aweeri/Control-Avionics-RP2350/Firmware/RapidFishFW/LITE/GPIO-table.md

GPIO 0: 
GPIO 1:
GPIO 2: I2C1 SDA
GPIO 3: I2C1 SCL
GPIO 4: I2C0 SDA
GPIO 5: I2C0 SCL
GPIO 6: RADIO DIO5
GPIO 7: RADIO DIO6
GPIO 8: GNSS UART1 TX
GPIO 9: GNSS UART1 RX
GPIO 10: RADIO BUSY
GPIO 11: RADIO RESET
GPIO 12: RADIO SPI1 RX [MISO]
GPIO 13: RADIO SPI1 CSn [CS]
GPIO 14: RADIO SPI1 SCK [SCL]
GPIO 15: RADIO SPI1 TX [MOSI]
GPIO 16: IMU SPI0 RX [MISO]
GPIO 17: IMU SPI0 CSn [CS]
GPIO 18: IMU SPI0 SCK [SCL]
GPIO 19: IMU SPI0 TX [MOSI]
GPIO 20: SERVO PWM2
GPIO 21: PYRO_1 TRIGGER
GPIO 22: PYRO_2 TRIGGER
GPIO 23: SERVO PWM1
GPIO 24: BUZZER TRIGGER
GPIO 25: WS2812B SIGNAL
GPIO 26: BATTERY VOLTAGE ADC
GPIO 27: UNUSED ADC
GPIO 28: PYRO_1 CONTINUITY ADC
GPIO 29: PYRO_2 CONTINUITY ADC
