aweeri/Control-Avionics-RP2350/Hardware/CARP-DEV/addons/BMP390/10LGA_2X2X0p75_BOS.stl

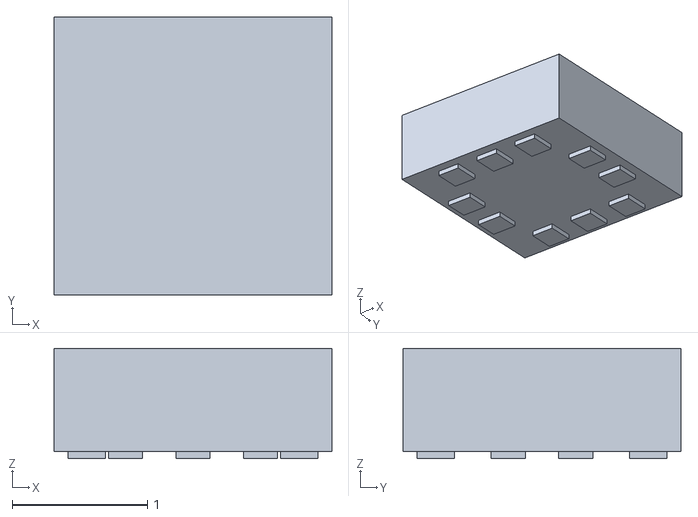
[picture p1: CAD file, 2026-06-29]
Hardware/CARP-DEV/addons/BMP390/10LGA_2X2X0p75_BOS.stl
2.06 x 2.06 x 0.815
