aweeri/Control-Avionics-RP2350/Hardware/CARP-DEV/RP2350_QFN60.step

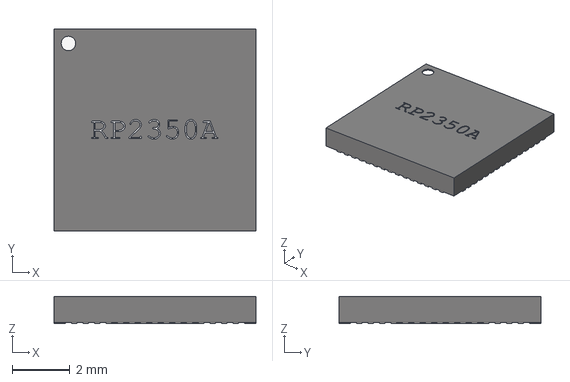
[picture p2: CAD file, 2026-06-29]
Hardware/CARP-DEV/RP2350_QFN60.step
7.00 x 7.00 x 0.95 mm
