aweeri/Control-Avionics-RP2350/Hardware/CARP-LITE/rev1.0/TEST_RESULTS.md

* OSP finish SUCKS.
* flash power disconnected, missed during drc stage
