aweeri/Control-Avionics-RP2350/Hardware/CARP-DEV/pdf/CARP.pdf

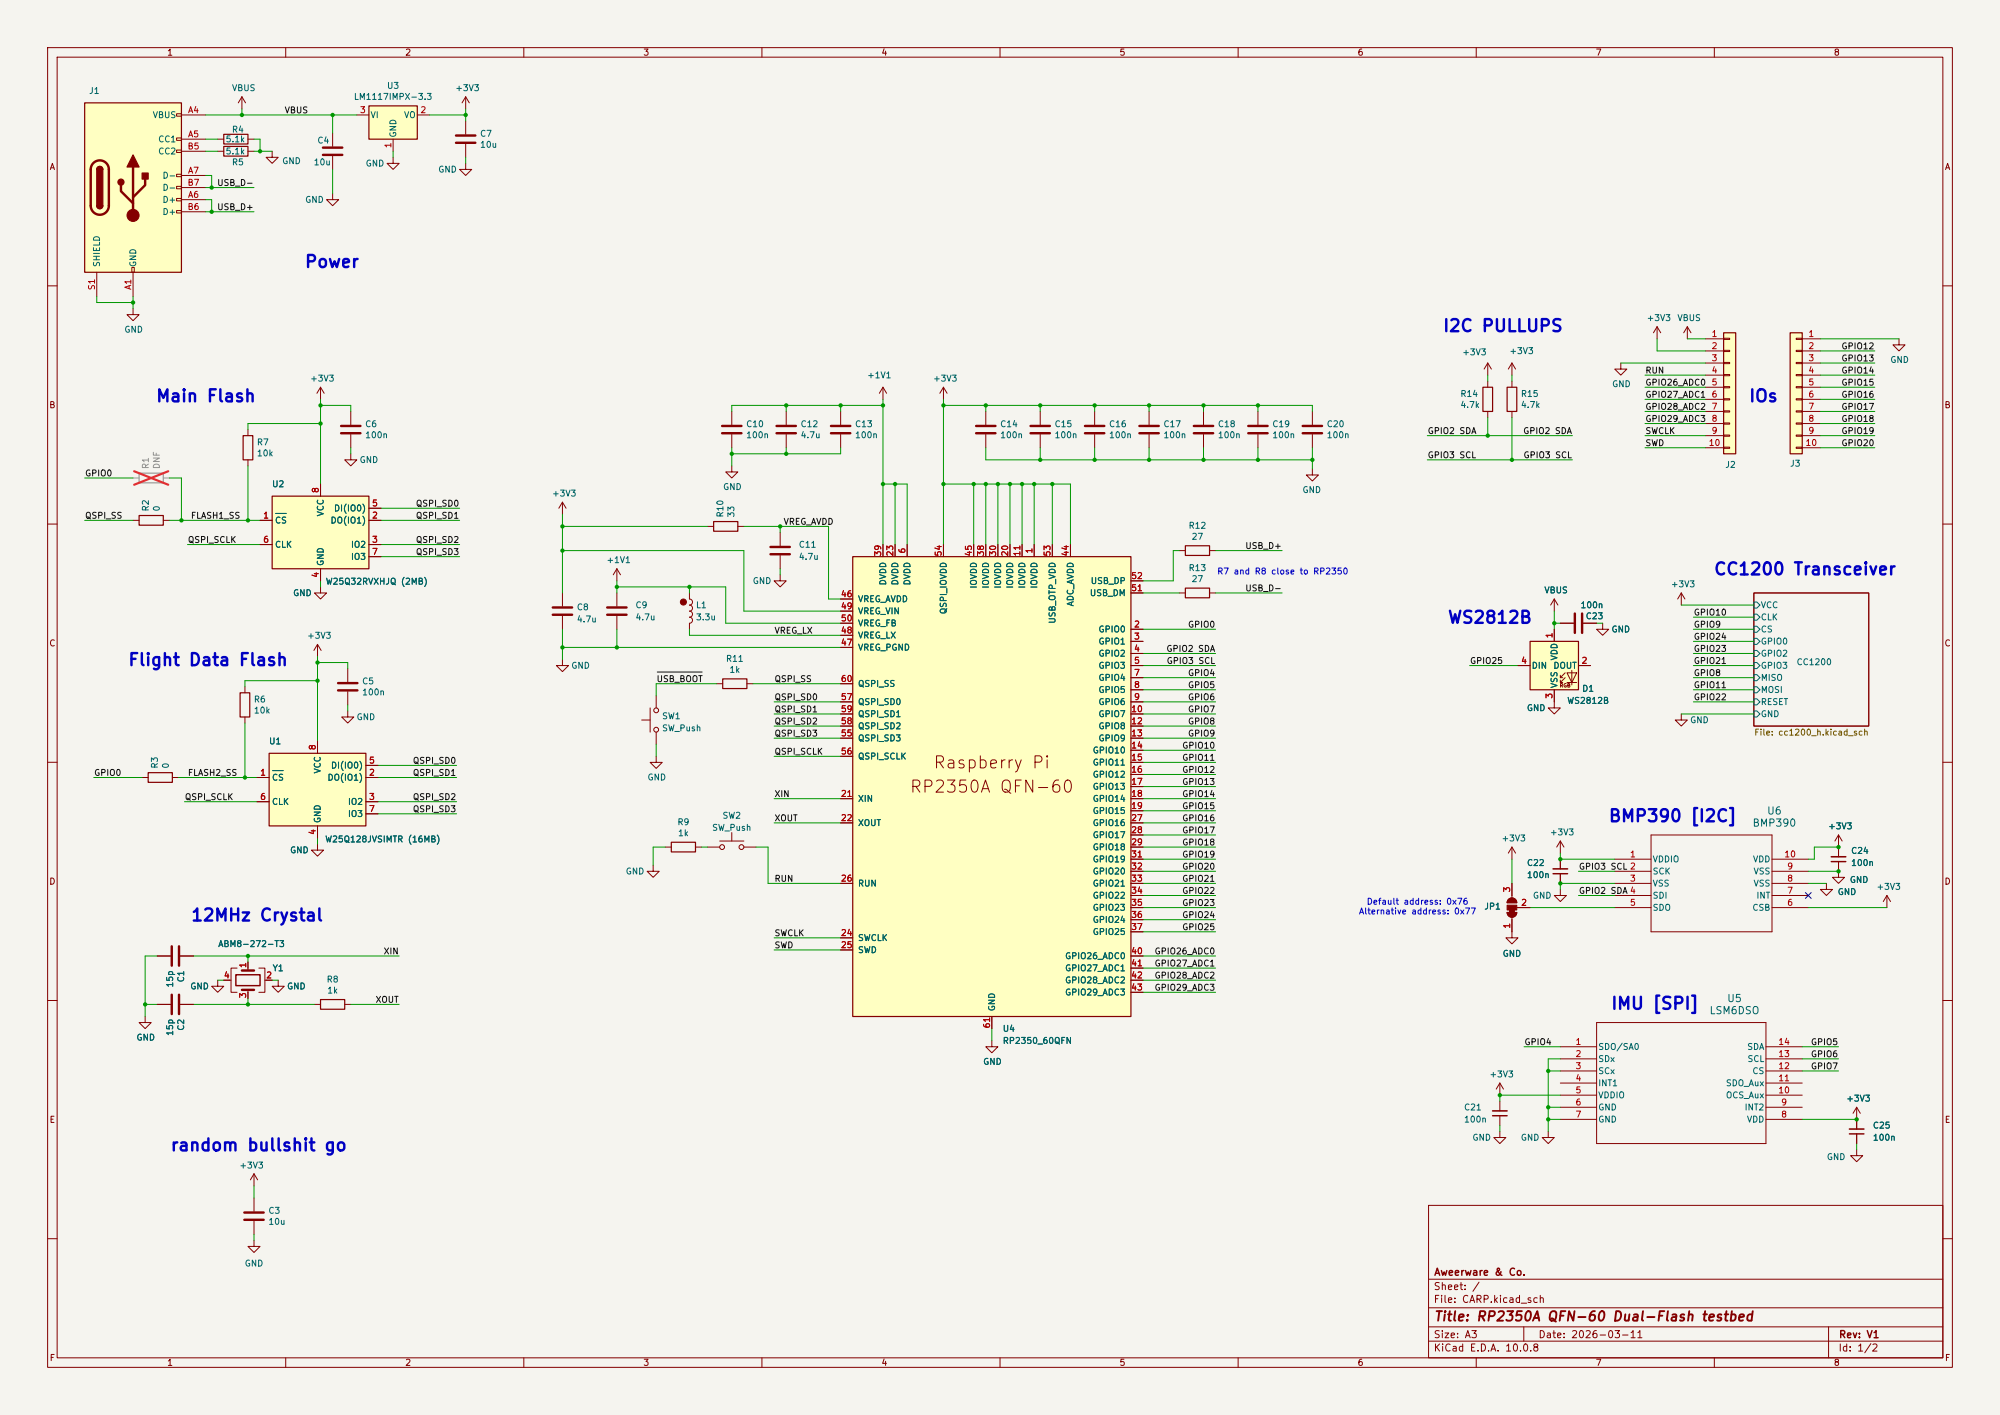
[picture p3: page 1]

VCC
CLK
CSGPIO0 GPIO2 GPIO3 MISO MOSI RESET GND

Aweerware & Co.
Sheet: /
File: CARP.kicad_sch
Title: RP2350A QFN-60 Dual-Flash testbed

Size: A3 | Rev: V1 | F Date: 2026-03-11
KiCad E.D.A. 10.0.8 | Id: 1/2

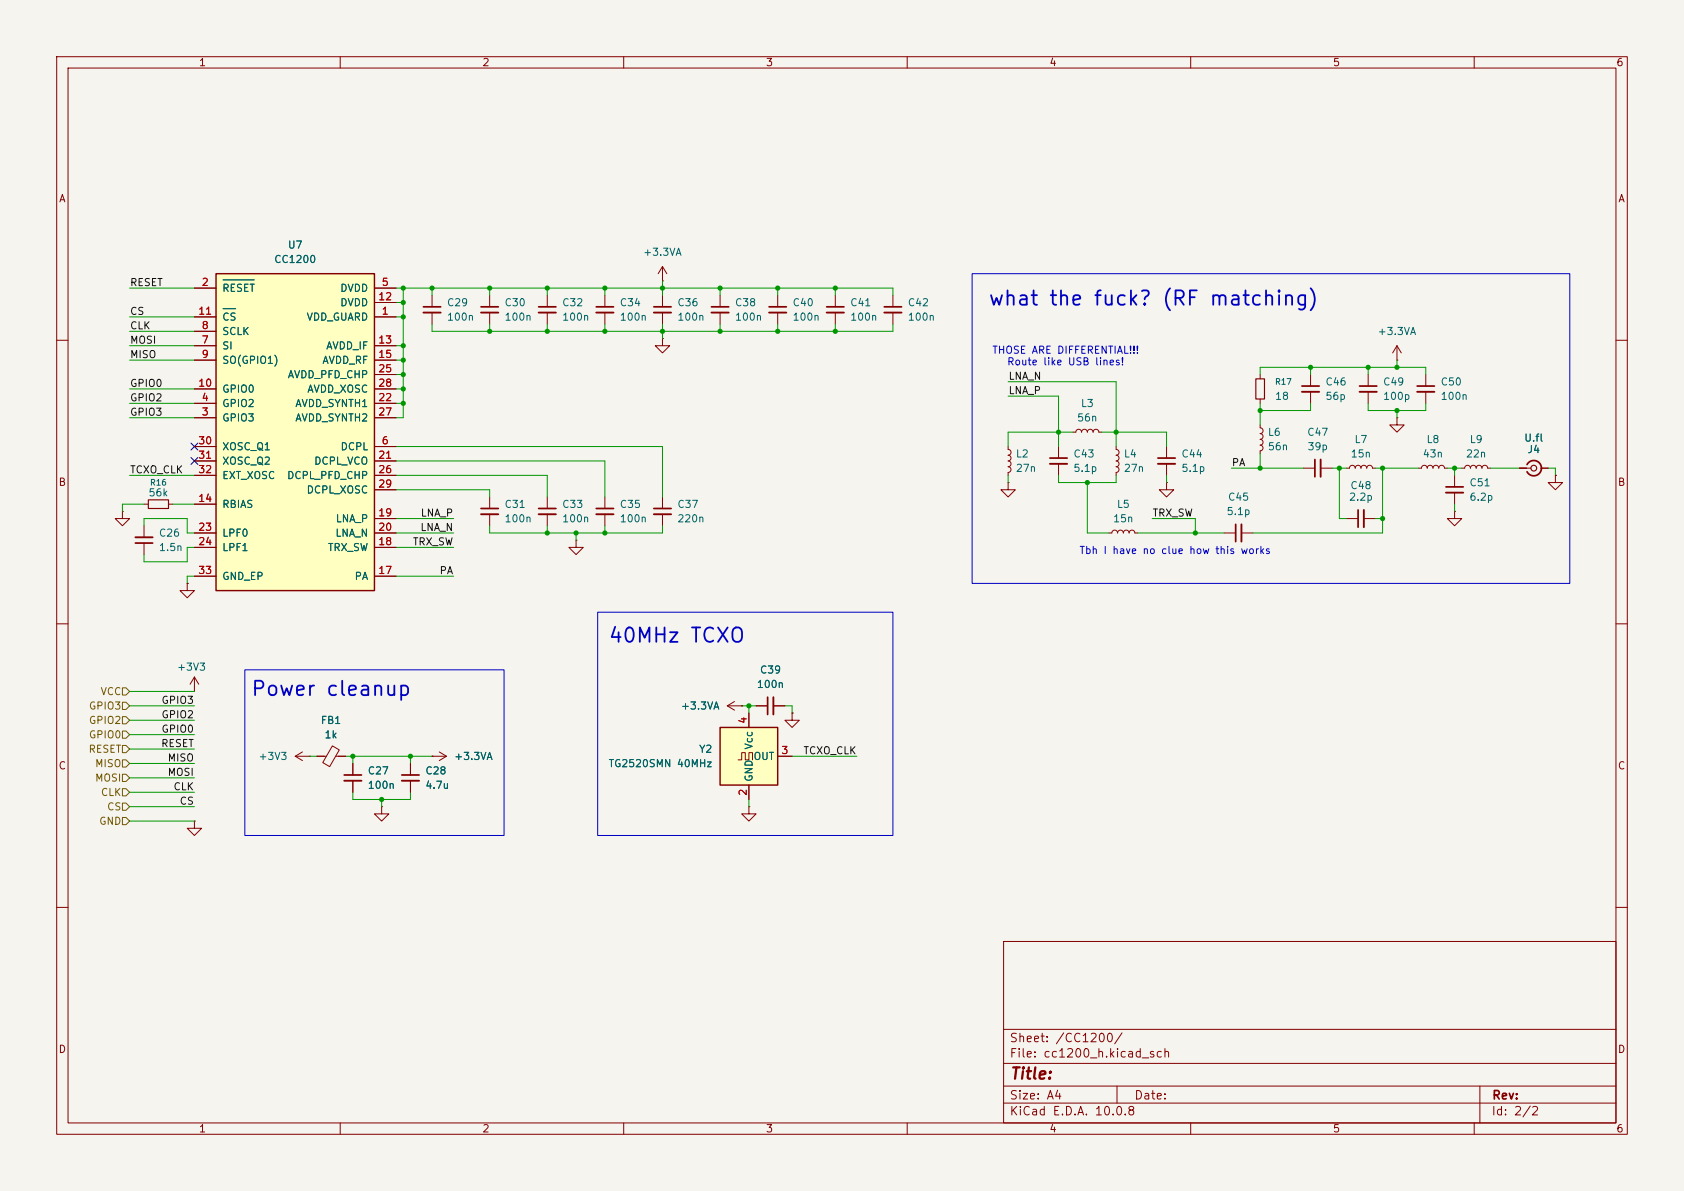
[picture p4: page 2]

GPIO0 GPIO3 GPIO0 GPIO2 CSRESET CLK MOSI MISO

what the fuck? (RF matching)

Tbh I have no clue how this works Power cleanup

CS CLK MOSI GND

Size: A4 | Rev:
KiCad E.D.A. 10.0.8 | Id: 2/2
