aweeri/Control-Avionics-RP2350/Hardware/CARP-LITE/rev2.0/pdf/CARP.pdf

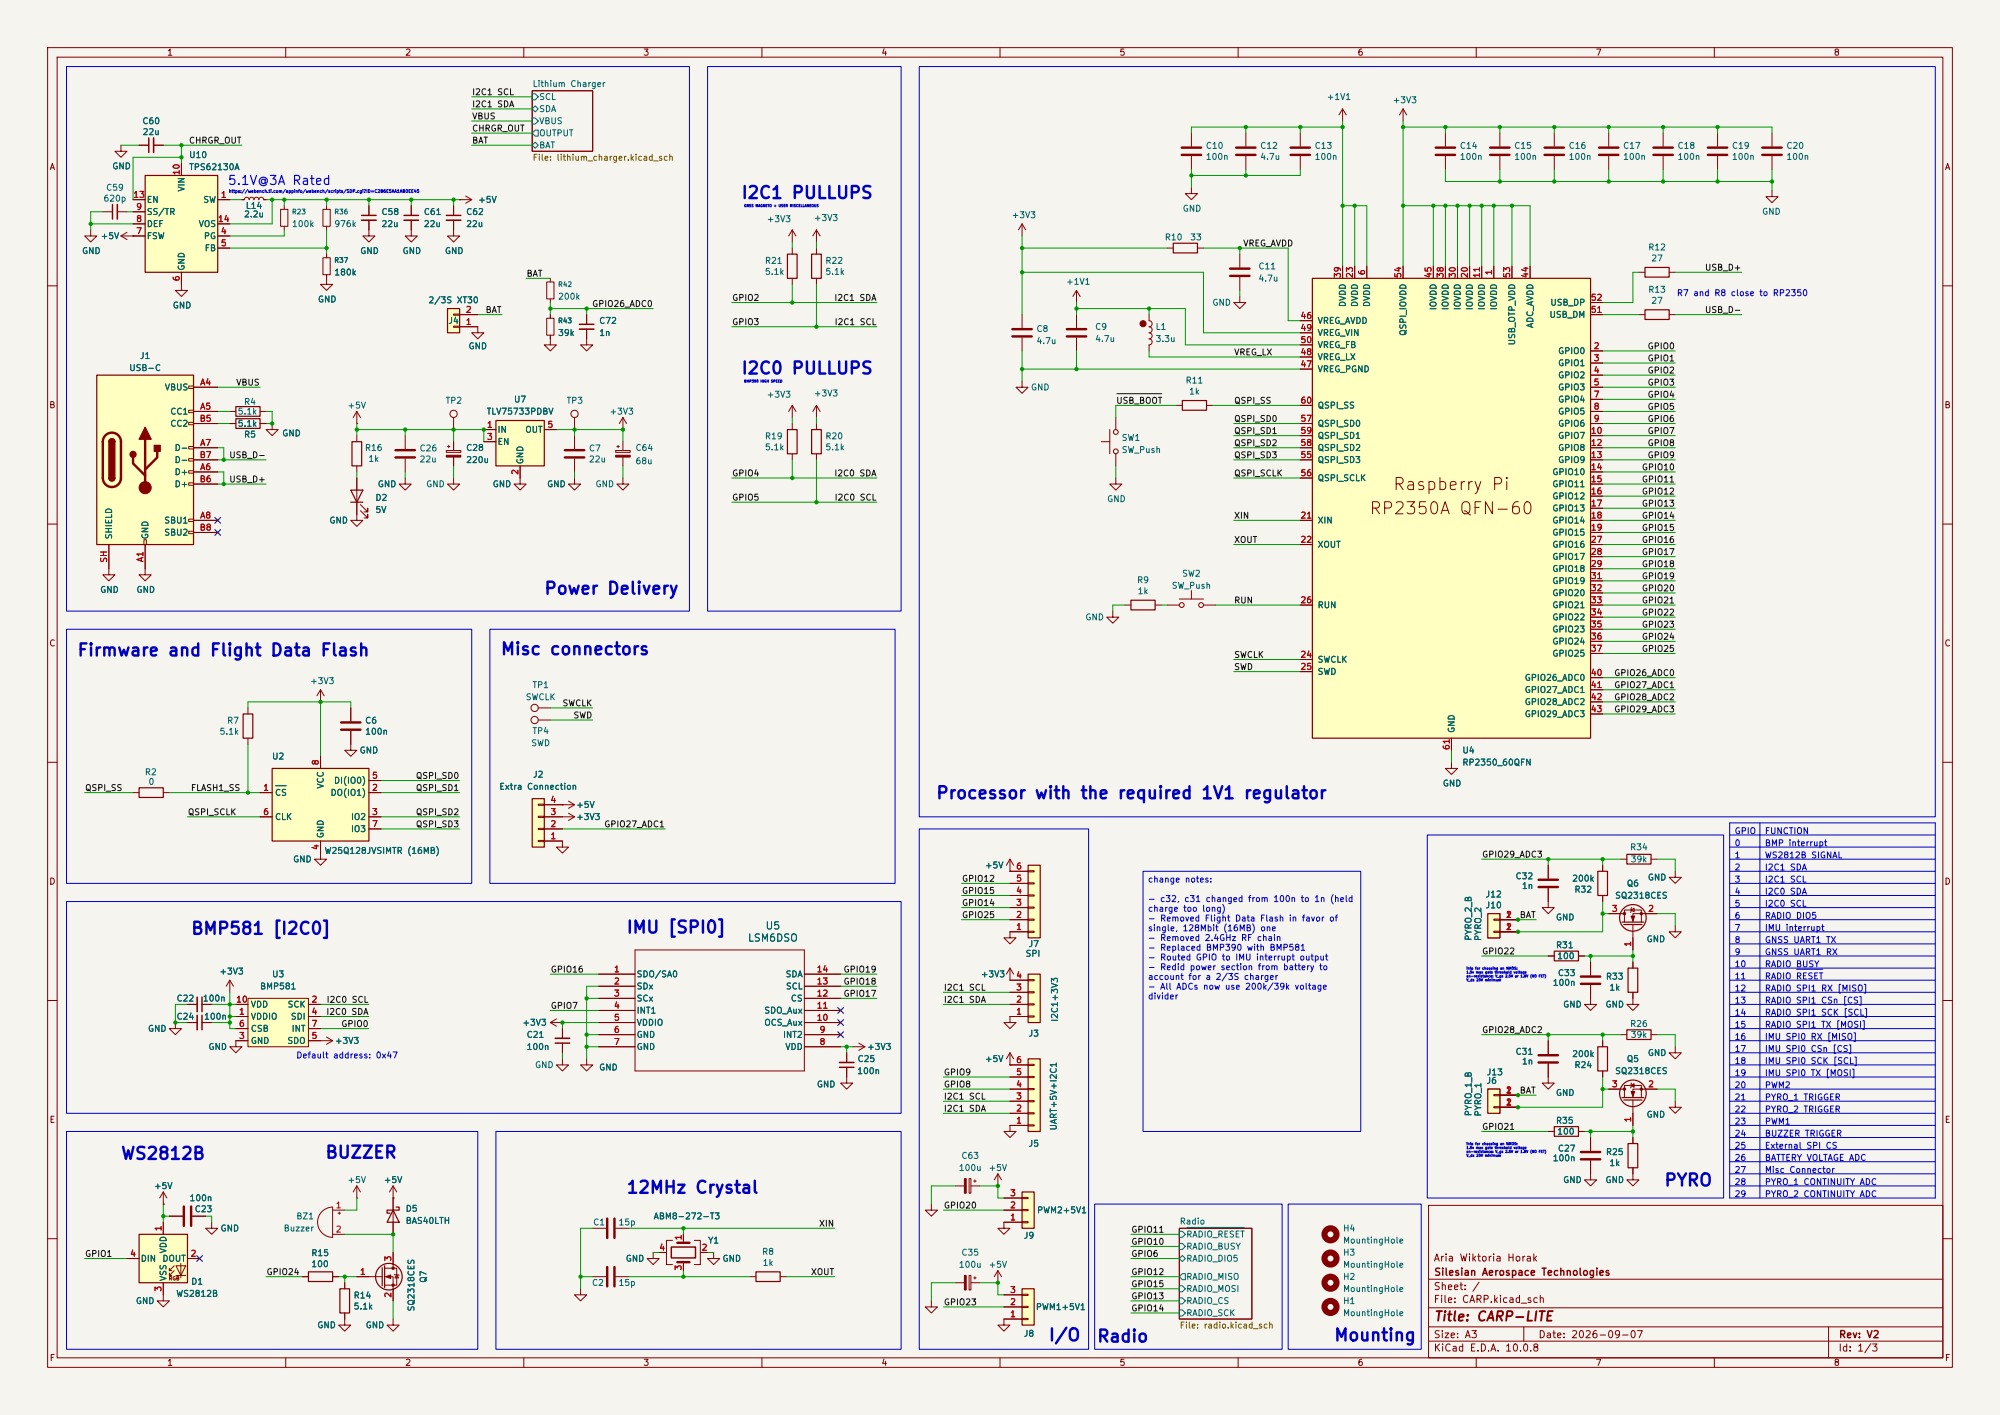
[picture p5: page 1]

VBUS BAT Lithium Charger File: lithium_charger.kicad_sch
OUTPUT SCL SDA

https://webench.ti.com/appinfo/webench/scripts/SDP.cgi?ID=C286E5AA1AB0EE45 Firmware and Flight Data Flash

info for choosing an NMOS: 1.5v max gate threshold voltage on-resistance: V_gs 2.5V or 1.8V (NO FET) V_ds 20V minimum Misc connectors

account for a 2/3S charger - All ADCs now use 200k/39k voltage divider Processor with the required 1V1 regulator
I2C1 SCL GPIO8GPIO12 GPIO14 GPIO15

change notes: - c32, c31 changed from 100n to 1n (held

charge too long) - Removed Flight Data Flash in favor of single, 128Mbit (16MB) one - Removed 2.4GHz RF chain - Replaced BMP390 with BMP581 - Routed GPIO to IMU interrupt output - Redid power section from battery to

info for choosing an NMOS: 1.5v max gate threshold voltage on-resistance: V_gs 2.5V or 1.8V (NO FET) V_ds 20V minimum
200k GND

21 | PYRO_1 TRIGGER
22 | PYRO_2 TRIGGER
23 | PWM1
24 | BUZZER TRIGGER
25 | External SPI CS
26 | BATTERY VOLTAGE ADC
27 | Misc Connector 28 PYRO_1 CONTINUITY ADC

29 | PYRO_2 CONTINUITY ADC

Size: A3 | Rev: V2 | F Date: 2026-09-07
KiCad E.D.A. 10.0.8 | Id: 1/3

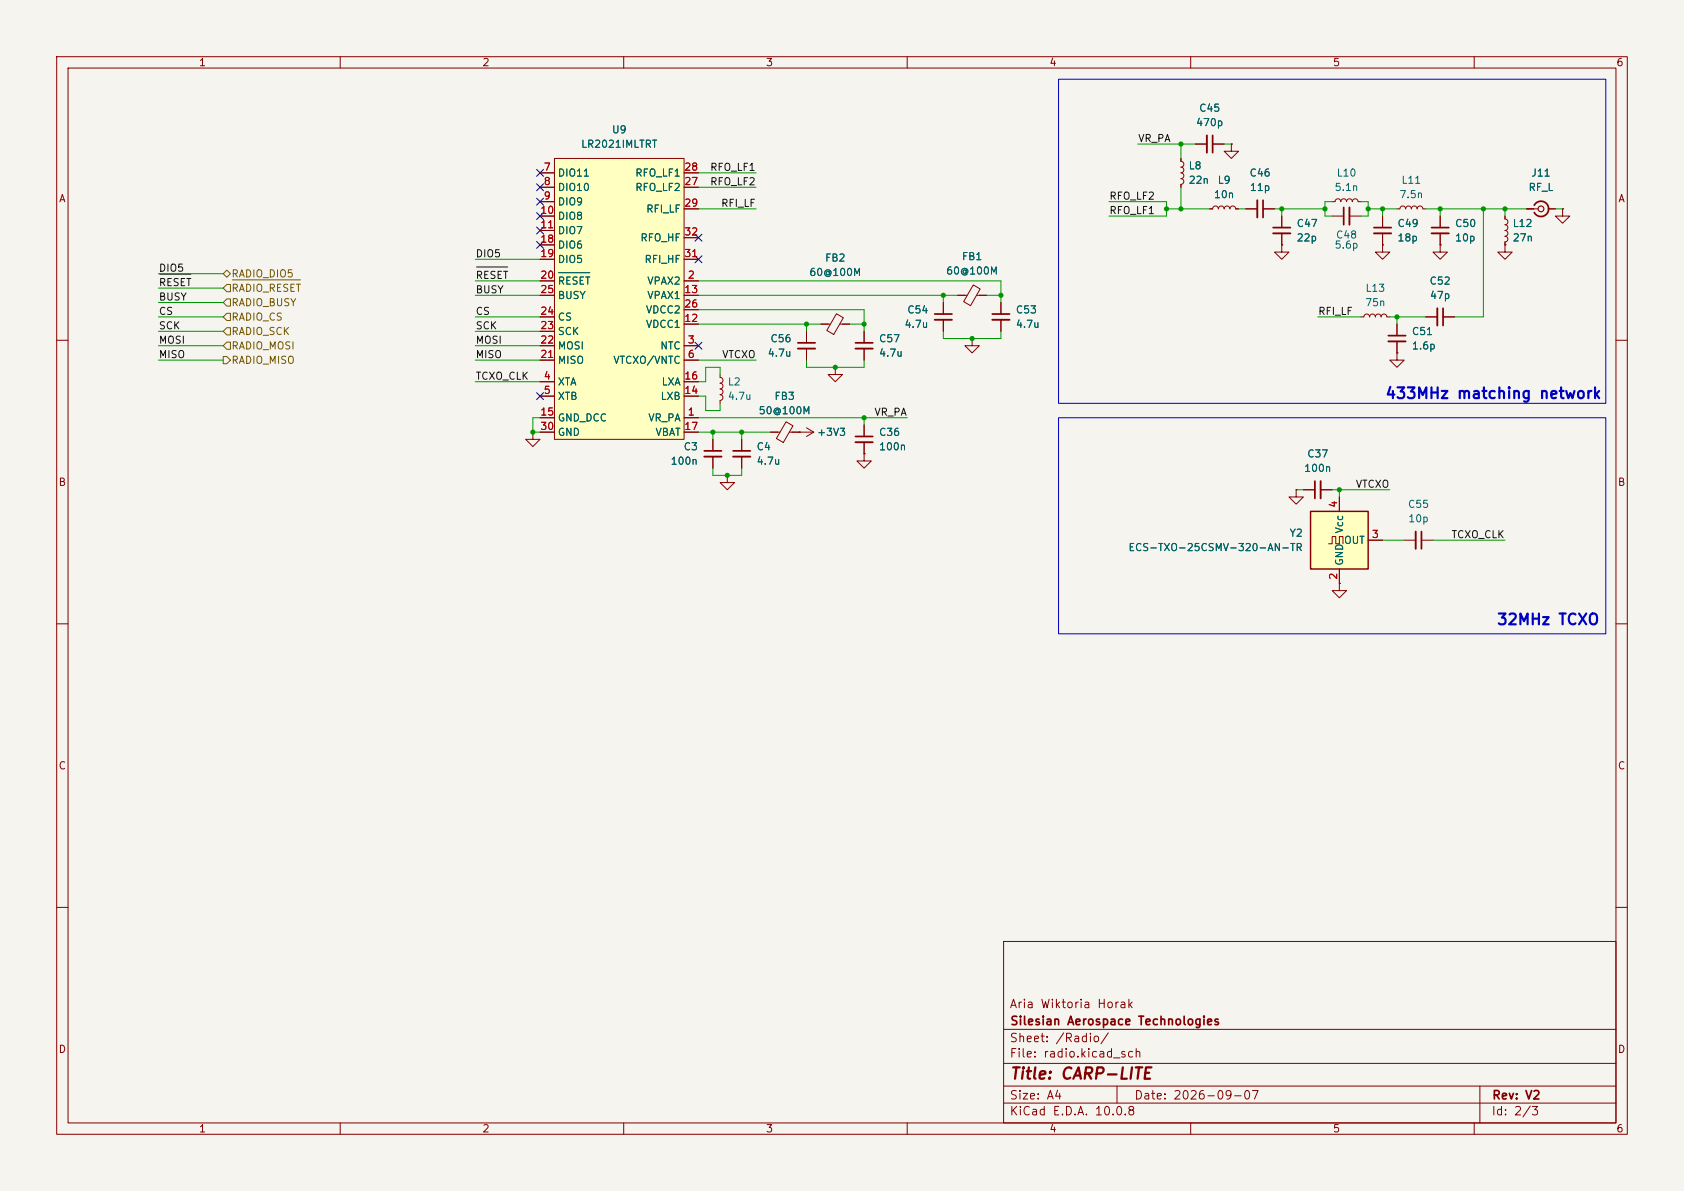
[picture p6: page 2]

VBAT 17 DIO6 18 DIO5 19 RESET 20 MISO 21 MOSI 22 SCK 23 CS 24 BUSY 25

ECS-TXO-25CSMV-320-AN-TR

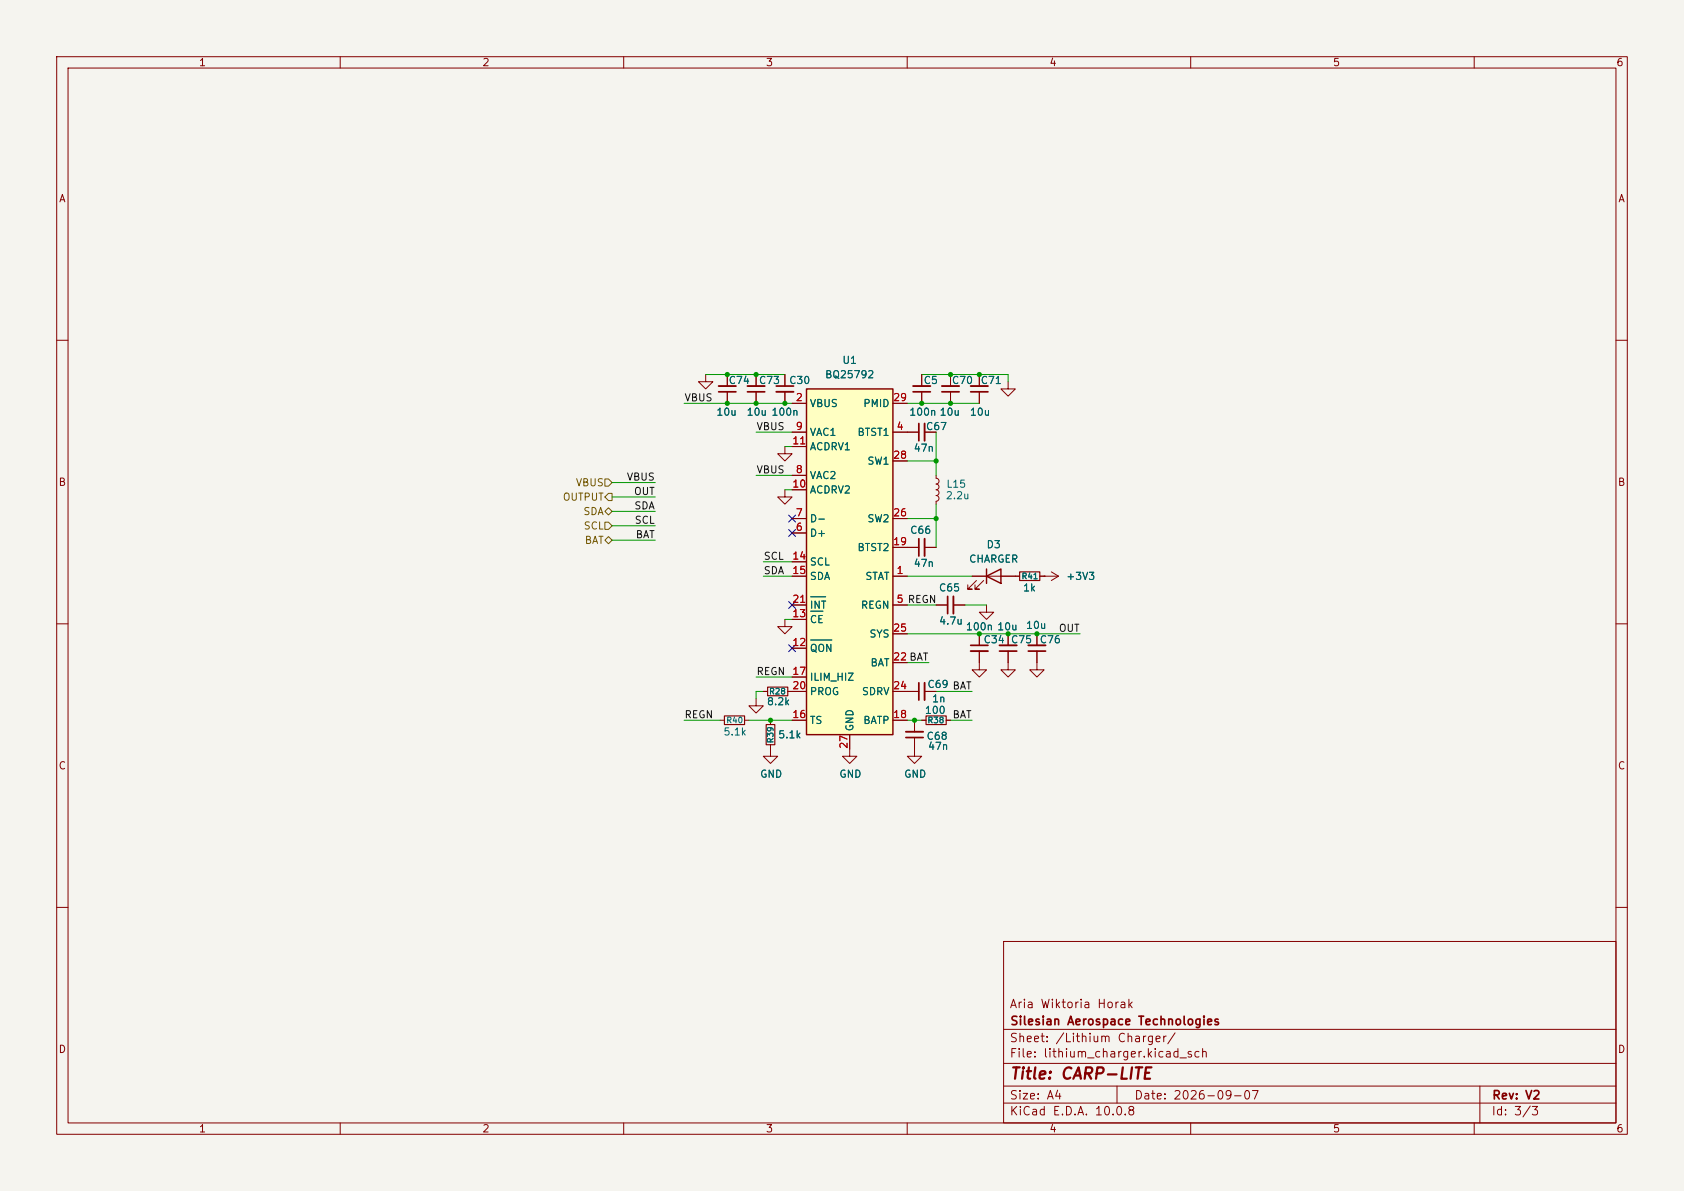
[picture p7: page 3]
