aweeri/Control-Avionics-RP2350/Hardware/CARP-LITE/rev1.0/pdf/CARP.pdf

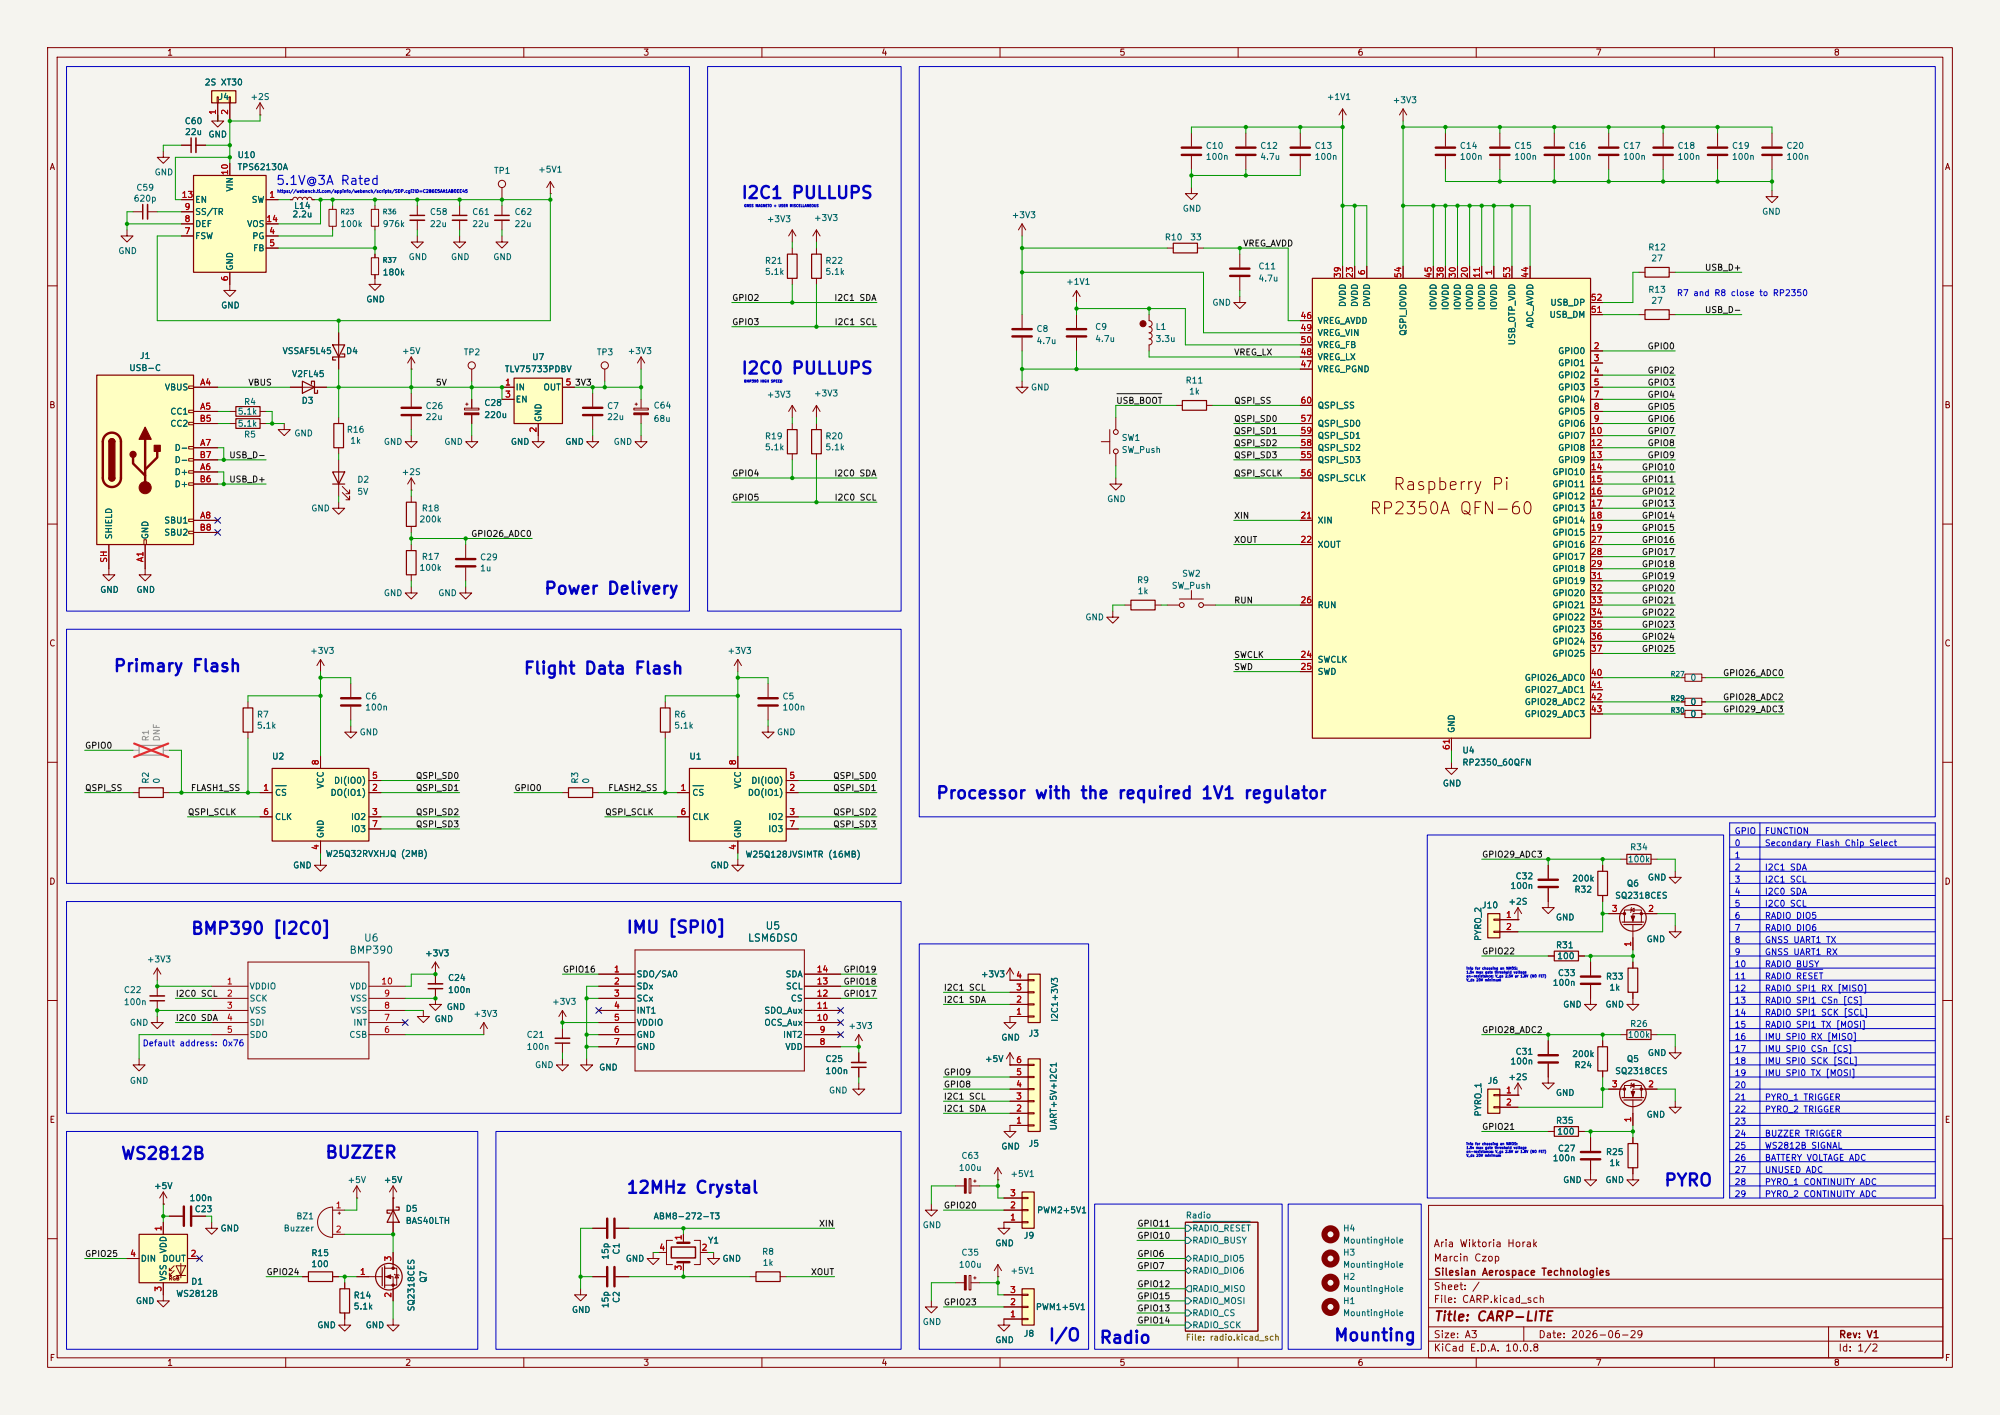
[picture p8: page 1]

GNSS MAGNETO + USER MISCELLANEOUS I2C1 PULLUPS 5.1V@3A Rated

https://webench.ti.com/appinfo/webench/scripts/SDP.cgi?ID=C286E5AA1AB0EE45

R7 and R8 close to RP2350 Primary Flash

Processor with the required 1V1 regulator

info for choosing an NMOS: 1.5v max gate threshold voltage on-resistance: V_gs 2.5V or 1.8V (NO FET) V_ds 20V minimum

21 | PYRO_1 TRIGGER
22 | PYRO_2 TRIGGER
23
24 | BUZZER TRIGGER
25 | WS2812B SIGNAL 26 BATTERY VOLTAGE ADC

27 | UNUSED ADC

Size: A3 | Rev: V1 | F Date: 2026-06-29
KiCad E.D.A. 10.0.8 | Id: 1/2

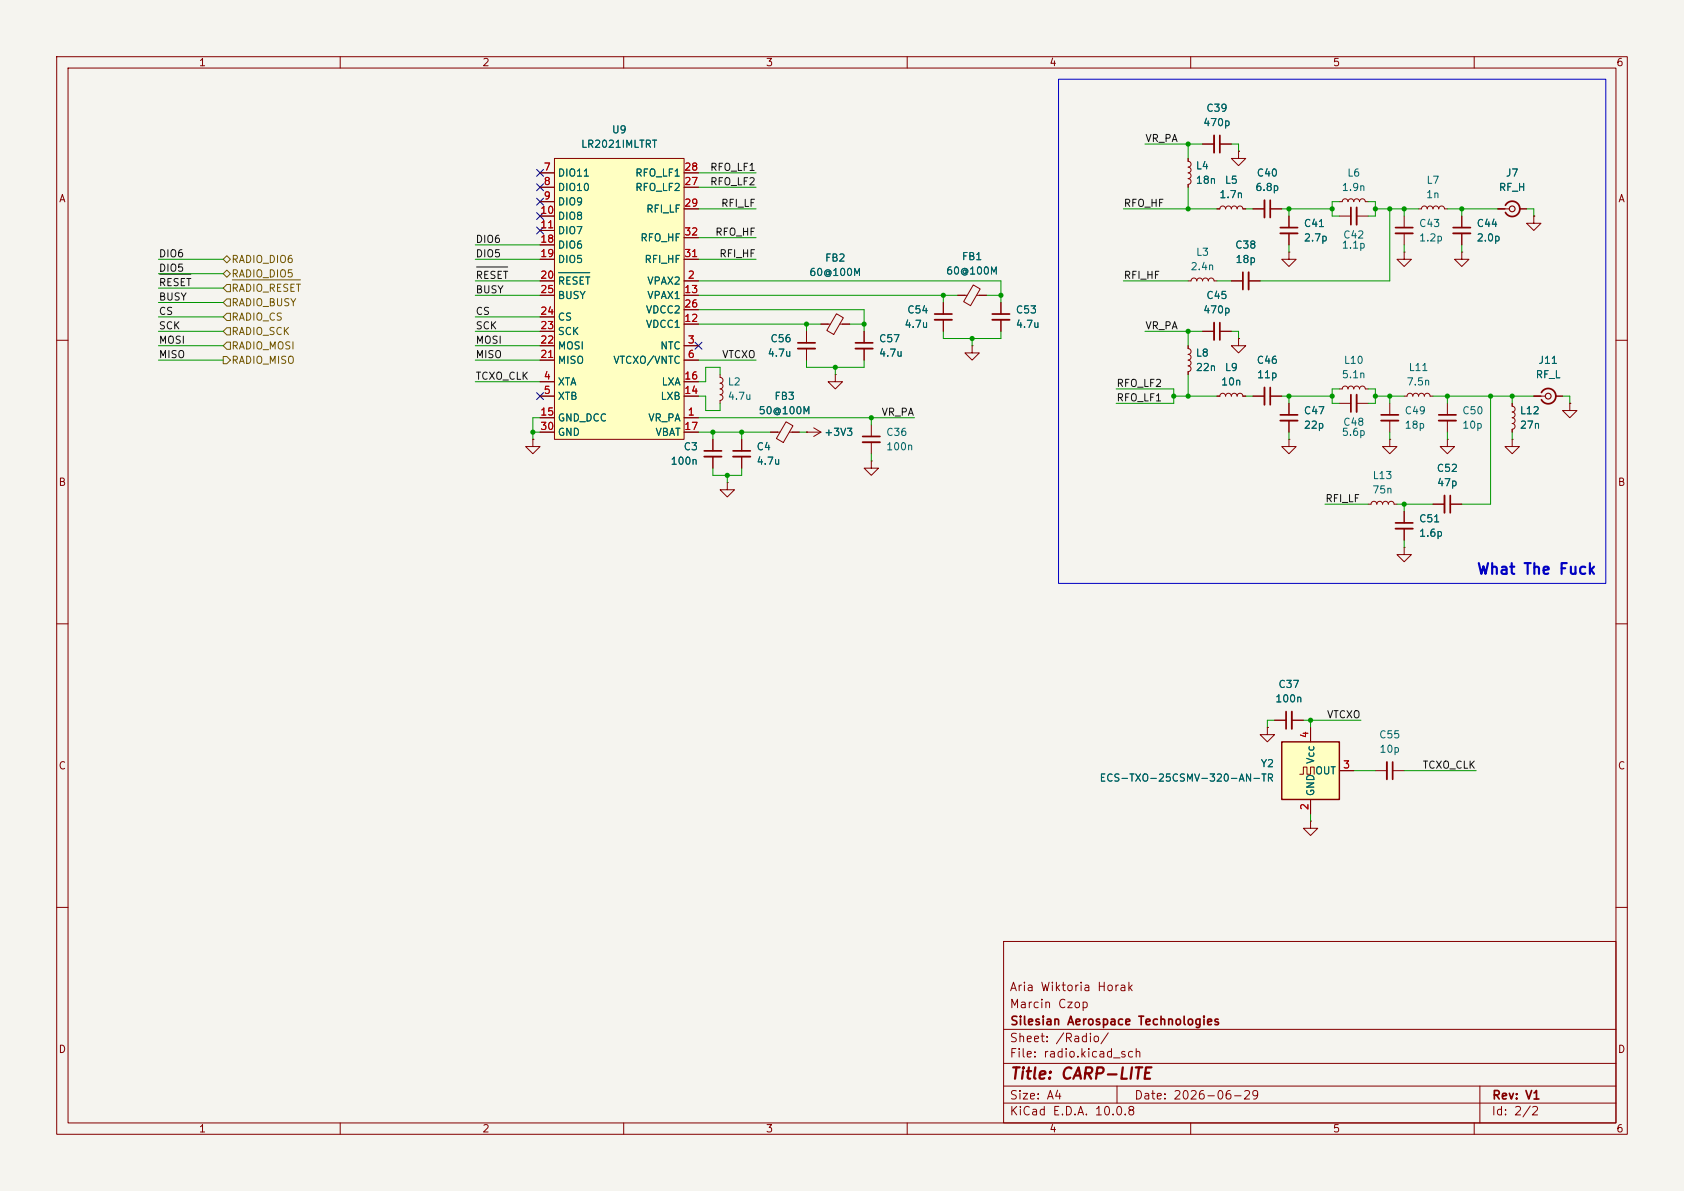
[picture p9: page 2]

VBAT 17 DIO6 18 DIO5 19 RESET 20 MISO 21 MOSI 22 SCK 23 CS 24 BUSY 25

ECS-TXO-25CSMV-320-AN-TR

Size: A4 | Rev: V1
KiCad E.D.A. 10.0.8 | Id: 2/2
