aweeri/Control-Avionics-RP2350/Hardware/CARP-LITE/rev2.0/CARP.kicad_pcb

## KiCad design Hardware/CARP-LITE/rev2.0/CARP.kicad_pcb (2026-11-10)

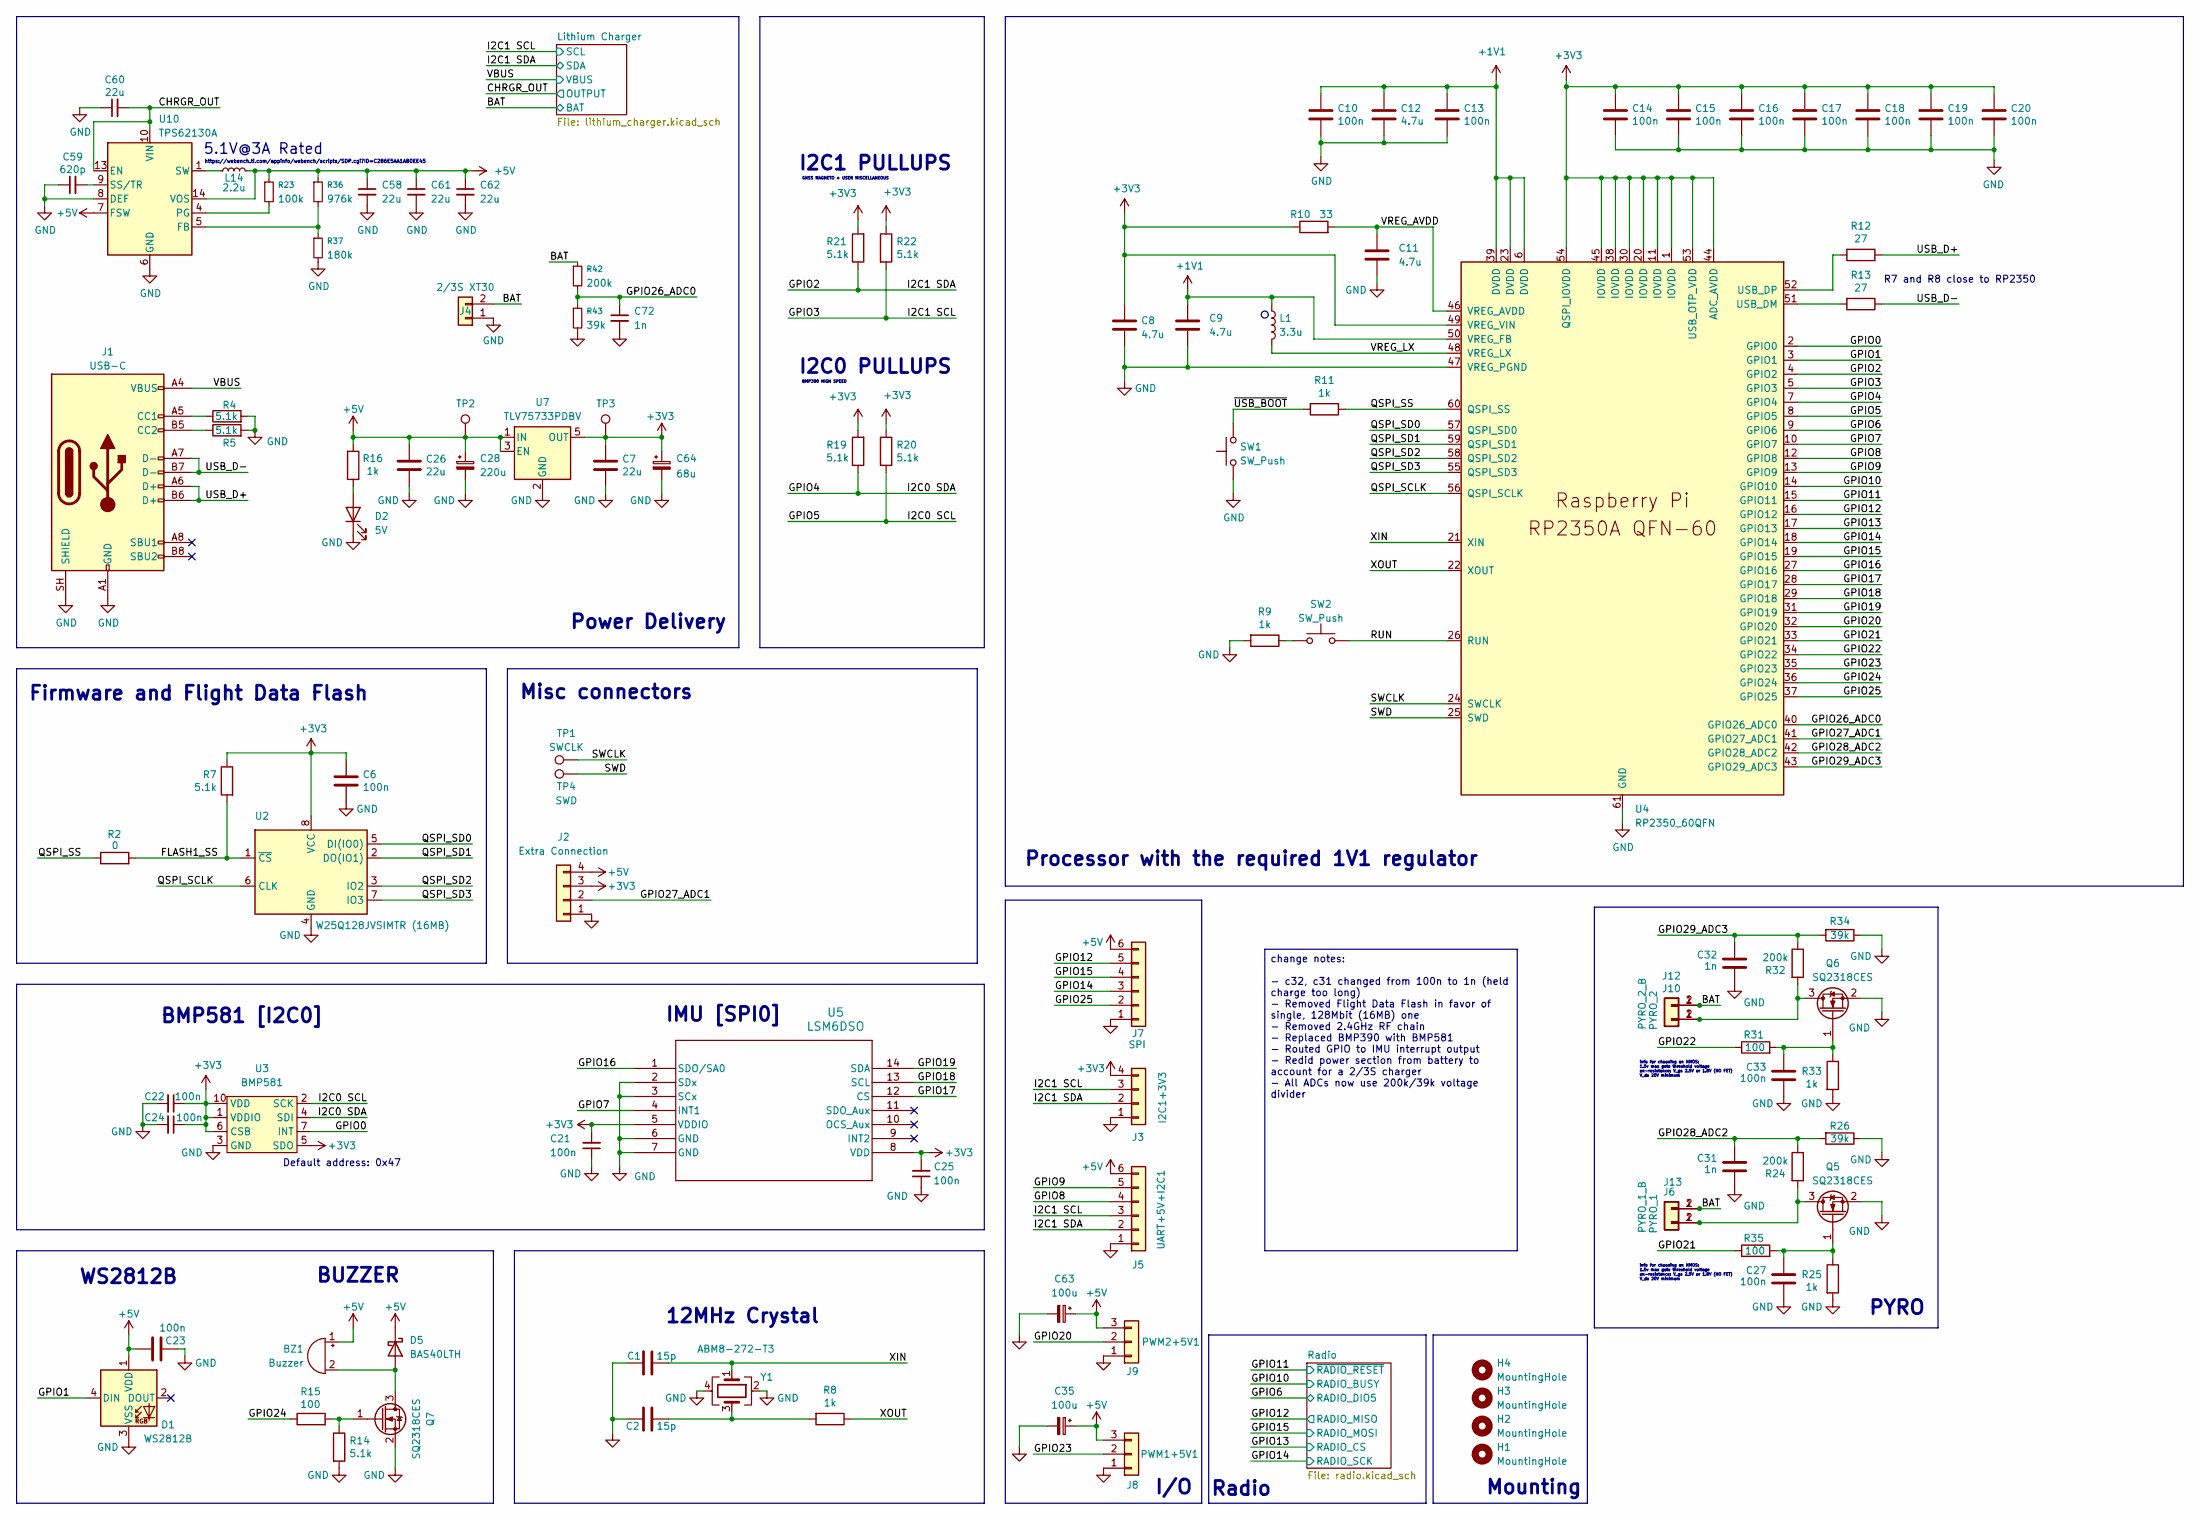
[picture p10: schematic CARP.kicad_sch, CARP-LITE]

Parts:
BZ1: Buzzer; Buzzer_12x9.5RM7.6
C1, C2: 15p; C_0402_1005Metric
C6, C10, C13, C14, C15, C16, C17, C18, C19, C20, C21, C22, C23, C24, C25, C27, C33: 100n; C_0402_1005Metric
C7, C26, C58, C60, C61, C62: 22u; C_0805_2012Metric
C8, C9: 4.7u; C_0402_1005Metric_small_pads
C11, C12: 4.7u; C_0402_1005Metric
C28: 220u; CP_EIA-7343-31_Kemet-D
C31, C32, C72: 1n; C_0402_1005Metric
C35, C63: 100u; CP_EIA-6032-28_Kemet-C
C59: 620p; C_0402_1005Metric
C64: 68u; CP_EIA-3528-21_Kemet-B
D1: WS2812B; LED_WS2812B_PLCC4_5.0x5.0mm_P3.2mm
D2: 5V; LED_0805_2012Metric
D5: BAS40LTH; D_SOD-882
H1, H2, H3, H4: MountingHole; MountingHole_3.2mm_M3_DIN965_Pad_TopBottom
J1: USB-C; USB_C_Receptacle_GCT_USB4105-xx-A_16P_TopMnt_Horizontal
J2: Extra Connection; Molex_PicoBlade_53047-0410_1x04_P1.25mm_Vertical
J3: I2C1+3V3; Molex_PicoBlade_53047-0410_1x04_P1.25mm_Vertical
J4: 2/3S XT30; AMASS_XT30PW-M_1x02_P2.50mm_Horizontal
J5: UART+5V+I2C1; Molex_PicoBlade_53047-0610_1x06_P1.25mm_Vertical
J6: PYRO_1; Molex_Nano-Fit_105309-xx02_1x02_P2.50mm_Vertical
J7: SPI; Molex_PicoBlade_53047-0610_1x06_P1.25mm_Vertical
J8: PWM1+5V1; Molex_PicoBlade_53047-0310_1x03_P1.25mm_Vertical
J9: PWM2+5V1; Molex_PicoBlade_53047-0310_1x03_P1.25mm_Vertical
J10: PYRO_2; Molex_Nano-Fit_105309-xx02_1x02_P2.50mm_Vertical
J12: PYRO_2_B; Molex_Nano-Fit_105313-xx02_1x02_P2.50mm_Horizontal
J13: PYRO_1_B; Molex_Nano-Fit_105313-xx02_1x02_P2.50mm_Horizontal
L1: 3.3u; L_pol_2016
L14: 2.2u; L_Coilcraft_XxL4020
Q5, Q6, Q7: SQ2318CES; SOT-23
R2: 0; R_0603_1608Metric
R4, R5, R7, R14, R19, R20, R21, R22: 5.1k; R_0402_1005Metric
R8, R9, R11, R16, R25, R33: 1k; R_0402_1005Metric
R10: 33; R_0402_1005Metric
R12, R13: 27; R_0402_1005Metric
R15, R31, R35: 100; R_0402_1005Metric
R23: 100k; R_0402_1005Metric
R24, R32, R42: 200k; R_0402_1005Metric
R26, R34, R43: 39k; R_0402_1005Metric
R36: 976k; R_0402_1005Metric
R37: 180k; R_0402_1005Metric
SW1, SW2: SW_Push; SW_Push_1P1T_XKB_TS-1187A
TP1: SWCLK; TestPoint_Pad_D1.5mm
TP2, TP3: TestPoint; TestPoint_Pad_D1.5mm
TP4: SWD; TestPoint_Pad_D1.5mm
U2: W25Q128JVSIMTR (16MB); SOIC-8_5.3x5.3mm_P1.27mm
U3: BMP581; 10LGA_2X2X0p75_BOS
U4: RP2350_60QFN; RP2350-QFN-60-1EP_7x7_P0.4mm_EP3.4x3.4mm_ThermalVias
U5: LSM6DSO; LGA-14L_2P5X3X0P86_STM
U7: TLV75733PDBV; SOT-23-5
U10: TPS62130A; VQFN-16-1EP_3x3mm_P0.5mm_EP1.68x1.68mm_ThermalVias
Y1: ABM8-272-T3; Crystal_SMD_3225-4Pin_3.2x2.5mm

Connections:
+1V1: C9.1, C10.1, C12.1, C13.1, L1.1, U4.6 (DVDD), U4.23 (DVDD), U4.39 (DVDD), U4.50 (VREG_FB)
+3V3: C6.1, C7.1, C8.1, C14.1, C15.1, C16.1, C17.1, C18.1, C19.1, C20.1, C21.2, C22.1, C24.1, C25.2, C64.1, J2.3, J3.4, R7.1, R10.1, R19.2, R20.1, R21.2, R22.1, TP3.1 (1_1), U2.8 (VCC), U3.1 (VDDIO), U3.5 (SDO), U3.6 (CSB), U3.10 (VDD), U4.1 (IOVDD), U4.11 (IOVDD), U4.20 (IOVDD), U4.30 (IOVDD), U4.38 (IOVDD), U4.44 (ADC_AVDD), U4.45 (IOVDD), U4.49 (VREG_VIN), U4.53 (USB_OTP_VDD), U4.54 (QSPI_IOVDD), U5.5 (VDDIO), U5.8 (VDD), U7.5 (OUT); also elsewhere on the board
+5V: BZ1.1 (+), C23.1, C26.1, C28.1, C35.1, C58.1, C61.1, C62.1, C63.1, D1.1 (VDD), D5.1 (K), J2.4, J5.6, J7.6, J8.3, J9.3, L14.2, R16.2, R23.1, R36.1, TP2.1 (1_1), U7.1 (IN), U7.3 (EN), U10.7 (FSW), U10.14 (VOS)
/BAT: J4.2, J6.1, J10.1, J12.2, J13.2, R42.1; also elsewhere on the board
/CHRGR_OUT: C60.2, U10.10 (VIN), U10.11 (VIN), U10.12 (VIN), U10.13 (EN); also elsewhere on the board
/FLASH1_SS: R2.2, R7.2, U2.1 (~CS)
/GPIO0: U3.7 (INT), U4.2 (GPIO0)
/GPIO1: D1.4 (DIN), U4.3 (GPIO1)
/GPIO2: J3.2, J5.2, R21.1, U4.4 (GPIO2); also elsewhere on the board
/GPIO3: J3.3, J5.3, R22.2, U4.5 (GPIO3); also elsewhere on the board
/GPIO4: R19.1, U3.4 (SDI), U4.7 (GPIO4)
/GPIO5: R20.2, U3.2 (SCK), U4.8 (GPIO5)
/GPIO6: U4.9 (GPIO6); also elsewhere on the board
/GPIO7: U4.10 (GPIO7), U5.4 (INT1)
/GPIO8: J5.4, U4.12 (GPIO8)
/GPIO9: J5.5, U4.13 (GPIO9)
/GPIO10: U4.14 (GPIO10); also elsewhere on the board
/GPIO11: U4.15 (GPIO11); also elsewhere on the board
/GPIO12: J7.5, U4.16 (GPIO12); also elsewhere on the board
/GPIO13: U4.17 (GPIO13); also elsewhere on the board
/GPIO14: J7.3, U4.18 (GPIO14); also elsewhere on the board
/GPIO15: J7.4, U4.19 (GPIO15); also elsewhere on the board
/GPIO16: U4.27 (GPIO16), U5.1 (SDO/SA0)
/GPIO17: U4.28 (GPIO17), U5.12 (CS)
/GPIO18: U4.29 (GPIO18), U5.13 (SCL)
/GPIO19: U4.31 (GPIO19), U5.14 (SDA)
/GPIO20: J9.2, U4.32 (GPIO20)
/GPIO21: R35.1, U4.33 (GPIO21)
/GPIO22: R31.1, U4.34 (GPIO22)
/GPIO23: J8.2, U4.35 (GPIO23)
/GPIO24: R15.1, U4.36 (GPIO24)
/GPIO25: J7.2, U4.37 (GPIO25)
/GPIO26_ADC0: C72.1, R42.2, R43.1, U4.40 (GPIO26_ADC0)
/GPIO27_ADC1: J2.2, U4.41 (GPIO27_ADC1)
/GPIO28_ADC2: C31.2, R24.1, R26.2, U4.42 (GPIO28_ADC2)
/GPIO29_ADC3: C32.2, R32.1, R34.2, U4.43 (GPIO29_ADC3)
/QSPI_SCLK: U2.6 (CLK), U4.56 (QSPI_SCLK)
/QSPI_SD0: U2.5 (DI(IO0)), U4.57 (QSPI_SD0)
/QSPI_SD1: U2.2 (DO(IO1)), U4.59 (QSPI_SD1)
/QSPI_SD2: U2.3 (IO2), U4.58 (QSPI_SD2)
/QSPI_SD3: U2.7 (IO3), U4.55 (QSPI_SD3)
/QSPI_SS: R2.1, R11.1, U4.60 (QSPI_SS)
/RUN: SW2.2, U4.26 (RUN)
/SWCLK: TP1.1 (1_1), U4.24 (SWCLK)
/SWD: TP4.1 (1_1), U4.25 (SWD)
/USB_D+: J1.A6 (D+), J1.B6 (D+), R12.1
/USB_D-: J1.A7 (D-), J1.B7 (D-), R13.1
/VBUS: J1.A4 (VBUS), J1.A9 (VBUS), J1.B4 (VBUS), J1.B9 (VBUS); also elsewhere on the board
/VREG_AVDD: C11.1, R10.2, U4.46 (VREG_AVDD)
/VREG_LX: L1.2, U4.48 (VREG_LX)
/XIN: C1.1, U4.21 (XIN), Y1.1
/XOUT: R8.1, U4.22 (XOUT)
/~USB_BOOT: R11.2, SW1.2
GND: C1.2, C2.2, C6.2, C7.2, C8.2, C9.2, C10.2, C11.2, C12.2, C13.2, C14.2, C15.2, C16.2, C17.2, C18.2, C19.2, C20.2, C21.1, C22.2, C23.2, C24.2, C25.1, C26.2, C27.1, C28.2, C31.1, C32.1, C33.1, C35.2, C58.2, C59.1, C60.1, C61.2, C62.2, C63.2, C64.2, C72.2, D1.3 (VSS), D2.1 (K), J1.A1 (GND), J1.A12 (GND), J1.B1 (GND), J1.B12 (GND), J1.SH (SHIELD), J2.1, J3.1, J4.1, J5.1, J7.1, J8.1, J9.1, Q5.2 (S), Q6.2 (S), Q7.2 (S), R4.2, R5.2, R9.2, R14.2, R25.2, R26.1, R33.2, R34.1, R37.2, R43.2, SW1.1, U2.4 (GND), U3.3 (GND), U3.8 (GND), U3.9 (GND), U4.47 (VREG_PGND), U4.61 (GND), U5.2 (SDx), U5.3 (SCx), U5.6 (GND), U5.7 (GND), U7.2 (GND), U10.6 (GND), U10.8 (DEF), U10.15 (GND), U10.16 (GND), U10.17 (GND), Y1.2, Y1.4; also elsewhere on the board
unnamed: BZ1.2 (-), D5.2 (A), Q7.3 (D)
unnamed: C2.1, R8.2, Y1.3
unnamed: D2.2 (A), R16.1
unnamed: J1.A5 (CC1), R4.1
unnamed: J1.B5 (CC2), R5.1
unnamed: J10.2, J12.1, Q6.3 (D), R32.2
unnamed: J6.2, J13.1, Q5.3 (D), R24.2
unnamed: L14.1, U10.1 (SW), U10.2 (SW), U10.3 (SW)
unnamed: C27.2, Q5.1 (G), R25.1, R35.2
unnamed: C33.2, Q6.1 (G), R31.2, R33.1
unnamed: Q7.1 (G), R14.1, R15.2
unnamed: R9.1, SW2.1
unnamed: R13.2, U4.51 (USB_DM)
unnamed: R12.2, U4.52 (USB_DP)
unnamed: R36.2, R37.1, U10.5 (FB)
unnamed: R23.2, U10.4 (PG)
unnamed: C59.2, U10.9 (SS/TR)

Notes on the sheet:
BUZZER
5.1V@3A Rated
PYRO
info for choosing an NMOS: 1.5v max gate threshold voltage on-resistance: V_gs 2.5V or 1.8V (NO FET) V_ds 20V minimum
https://webench.ti.com/appinfo/webench/scripts/SDP.cgi?ID=C286E5AA1AB0EE45
Misc connectors
I2C1 PULLUPS
I2C0 PULLUPS
Firmware and Flight Data Flash
GNSS MAGNETO + USER MISCELLANEOUS
Radio
WS2812B
R7 and R8 close to RP2350
IMU [SPI0]
Default address: 0x47
I/O
Mounting
BMP581 [I2C0]
BMP390 HIGH SPEED
12MHz Crystal
Power Delivery
Processor with the required 1V1 regulator
change notes: - c32, c31 changed from 100n to 1n (held charge too long) - Removed Flight Data Flash in favor of single, 128Mbit (16MB) one - Removed 2.4GHz RF chain - Replaced BMP390 with BMP581 - Routed GPIO to IMU interrupt output - Redid power section from battery to account for a 2/3S charger -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

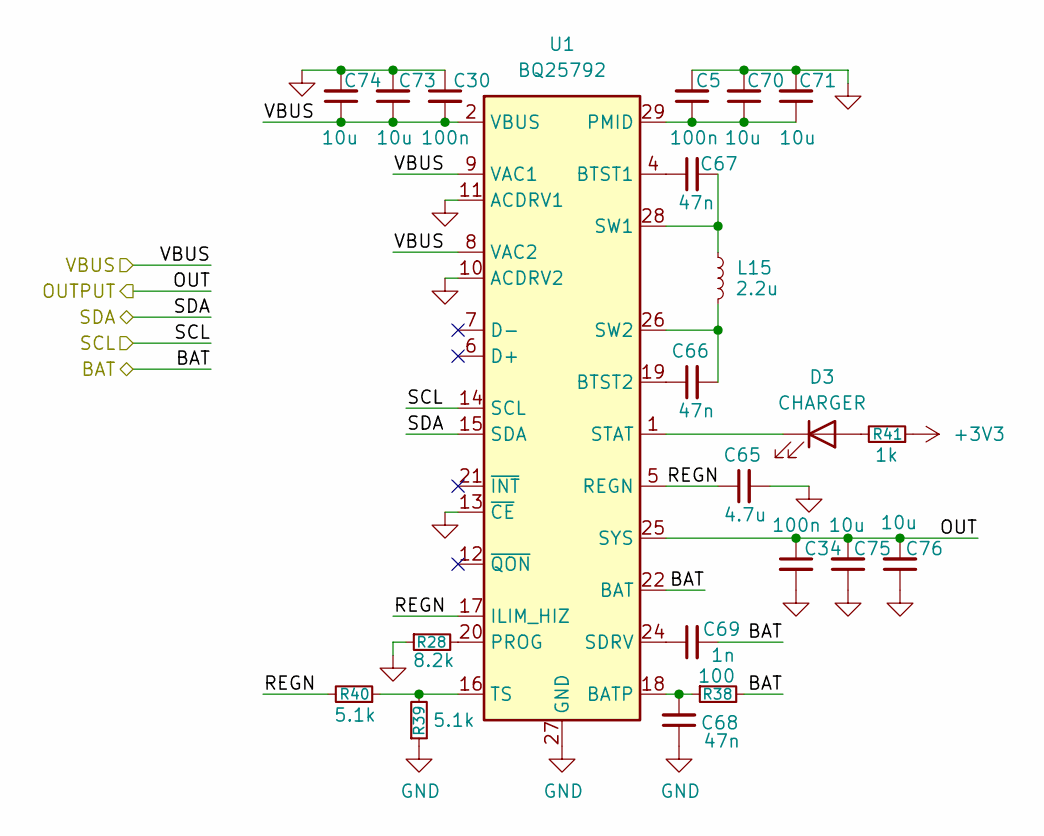
[picture p11: schematic lithium_charger.kicad_sch, CARP-LITE]

Parts:
C5, C30, C34: 100n; C_0402_1005Metric
C65: 4.7u; C_0603_1608Metric
C66, C67, C68: 47n; C_0402_1005Metric
C69: 1n; C_0402_1005Metric
C70, C71, C73, C74, C75, C76: 10u; C_0805_2012Metric
D3: CHARGER; LED_0805_2012Metric
L15: 2.2u; L_Coilcraft_XFL2010
R28: 8.2k; R_0402_1005Metric
R38: 100; R_0402_1005Metric
R39, R40: 5.1k; R_0402_1005Metric
R41: 1k; R_0402_1005Metric
U1: BQ25792; Texas_RQM0029A_VQFN-29_4x4mm_P0.4mm

Connections:
+3V3: R41.1; also elsewhere on the board
/BAT: C69.2, R38.2, U1.22 (BAT), U1.23 (BAT); also elsewhere on the board
/CHRGR_OUT: C34.1, C75.2, C76.2, U1.25 (SYS); also elsewhere on the board
/GPIO2: U1.15 (SDA); also elsewhere on the board
/GPIO3: U1.14 (SCL); also elsewhere on the board
/Lithium Charger/REGN: C65.1, R40.2, U1.5 (REGN), U1.17 (ILIM_HIZ)
/VBUS: C30.2, C73.1, C74.1, U1.2 (VBUS), U1.3 (VBUS), U1.8 (VAC2), U1.9 (VAC1); also elsewhere on the board
GND: C5.2, C30.1, C34.2, C65.2, C68.1, C70.2, C71.2, C73.2, C74.2, C75.1, C76.1, R28.1, R39.1, U1.10 (ACDRV2), U1.11 (ACDRV1), U1.13 (~CE), U1.27 (GND); also elsewhere on the board
unnamed: D3.2 (A), R41.2
unnamed: D3.1 (K), U1.1 (STAT)
unnamed: C68.2, R38.1, U1.18 (BATP)
unnamed: C67.1, U1.4 (BTST1)
unnamed: C66.1, U1.19 (BTST2)
unnamed: C5.1, C70.1, C71.1, U1.29 (PMID)
unnamed: R28.2, U1.20 (PROG)
unnamed: C69.1, U1.24 (SDRV)
unnamed: C67.2, L15.1, U1.28 (SW1)
unnamed: C66.2, L15.2, U1.26 (SW2)
unnamed: R39.2, R40.1, U1.16 (TS)

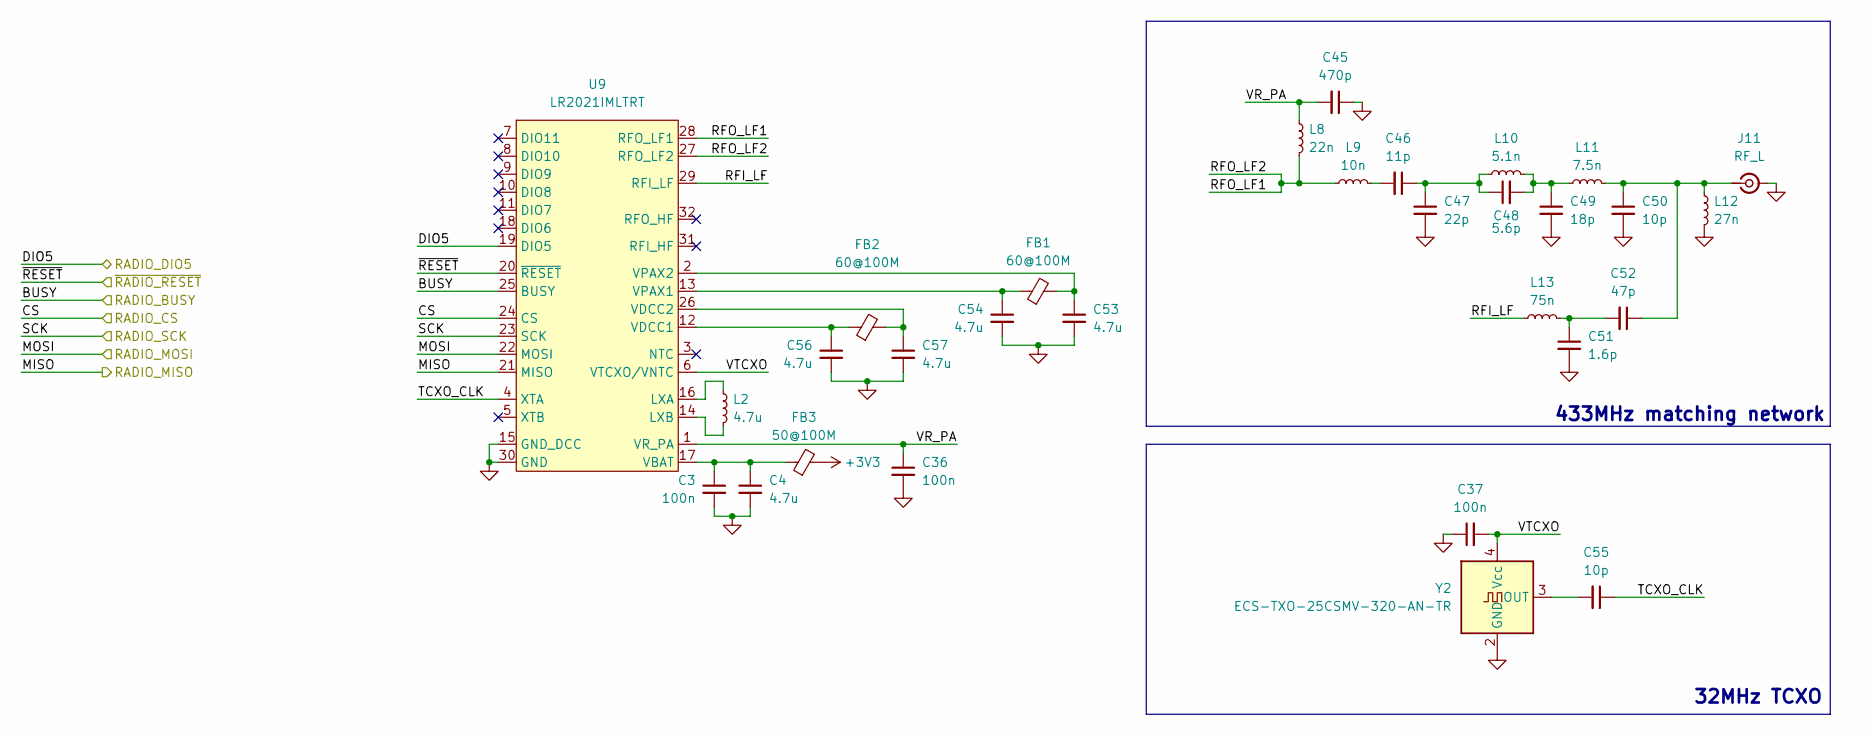
[picture p12: schematic radio.kicad_sch, CARP-LITE]

Parts:
C3, C36, C37: 100n; C_0402_1005Metric
C4, C53, C54, C56, C57: 4.7u; C_0603_1608Metric
C45: 470p; C_0402_1005Metric
C46: 11p; C_0402_1005Metric
C47: 22p; C_0402_1005Metric
C48: 5.6p; C_0402_1005Metric
C49: 18p; C_0402_1005Metric
C50, C55: 10p; C_0402_1005Metric
C51: 1.6p; C_0402_1005Metric
C52: 47p; C_0402_1005Metric
FB1, FB2: 60@100M; L_0603_1608Metric
FB3: 50@100M; L_0603_1608Metric
J11: RF_L; U.FL_Hirose_U.FL-R-SMT-1_Vertical
L2: 4.7u; L_1008_2520Metric
L8: 22n; L_0402_1005Metric
L9: 10n; L_0402_1005Metric
L10: 5.1n; L_0402_1005Metric
L11: 7.5n; L_0402_1005Metric
L12: 27n; L_0402_1005Metric
L13: 75n; L_0402_1005Metric
U9: LR2021IMLTRT; QFN-32-1EP_5x5mm_P0.5mm_EP3.7x3.7mm_ThermalVias
Y2: ECS-TXO-25CSMV-320-AN-TR; Oscillator_SMD_ECS_2520MV-xxx-xx-4Pin_2.5x2.0mm

Connections:
+3V3: FB3.2; also elsewhere on the board
/GPIO6: U9.19 (DIO5); also elsewhere on the board
/GPIO10: U9.25 (BUSY); also elsewhere on the board
/GPIO11: U9.20 (~RESET); also elsewhere on the board
/GPIO12: U9.21 (MISO); also elsewhere on the board
/GPIO13: U9.24 (CS); also elsewhere on the board
/GPIO14: U9.23 (SCK); also elsewhere on the board
/GPIO15: U9.22 (MOSI); also elsewhere on the board
/Radio/RFI_LF: L13.1, U9.29 (RFI_LF)
/Radio/RFO_LF1: L8.2, L9.1, U9.27 (RFO_LF2), U9.28 (RFO_LF1)
/Radio/TCXO_CLK: C55.1, U9.4 (XTA)
/Radio/VR_PA: C36.1, C45.2, L8.1, U9.1 (VR_PA)
/Radio/VTCXO: C37.2, U9.6 (VTCXO/VNTC), Y2.4 (Vcc)
GND: C3.2, C4.2, C36.2, C37.1, C45.1, C47.2, C49.2, C50.2, C51.2, C53.2, C54.2, C56.2, C57.2, J11.2 (Ext), L12.2, U9.15 (GND_DCC), U9.30 (GND), U9.33 (GND), Y2.2 (GND); also elsewhere on the board
unnamed: C46.1, C47.1, C48.1, L10.1
unnamed: C46.2, L9.2
unnamed: C48.2, C49.1, L10.2, L11.1
unnamed: C51.1, C52.2, L13.2
unnamed: C50.1, C52.1, J11.1 (In), L11.2, L12.1
unnamed: L2.1, U9.16 (LXA)
unnamed: L2.2, U9.14 (LXB)
unnamed: C3.1, C4.1, FB3.1, U9.17 (VBAT)
unnamed: C56.1, FB2.1, U9.12 (VDCC1)
unnamed: C57.1, FB2.2, U9.26 (VDCC2)
unnamed: C54.1, FB1.1, U9.13 (VPAX1)
unnamed: C53.1, FB1.2, U9.2 (VPAX2)
unnamed: C55.2, Y2.3 (OUT)

Notes on the sheet:
433MHz matching network
32MHz TCXO

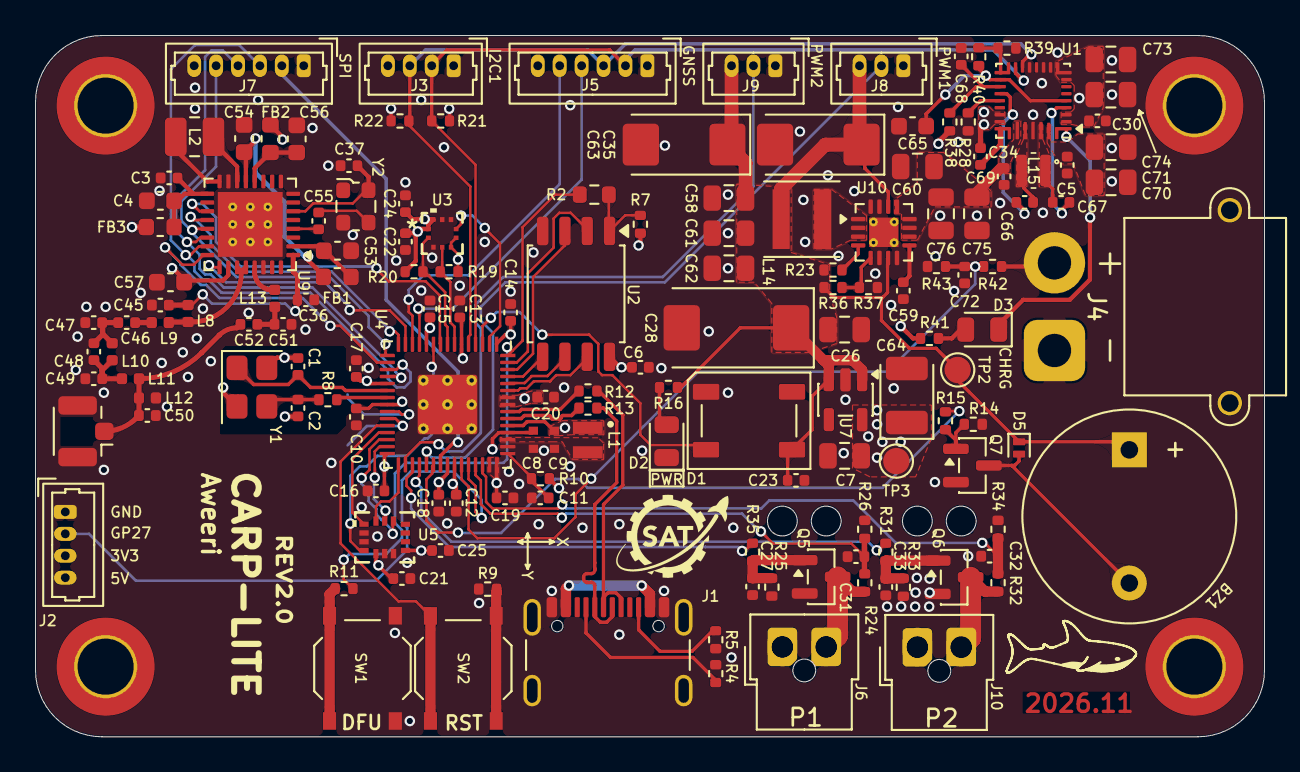
[picture p13: board Hardware/CARP-LITE/rev2.0/CARP.kicad_pcb from above]

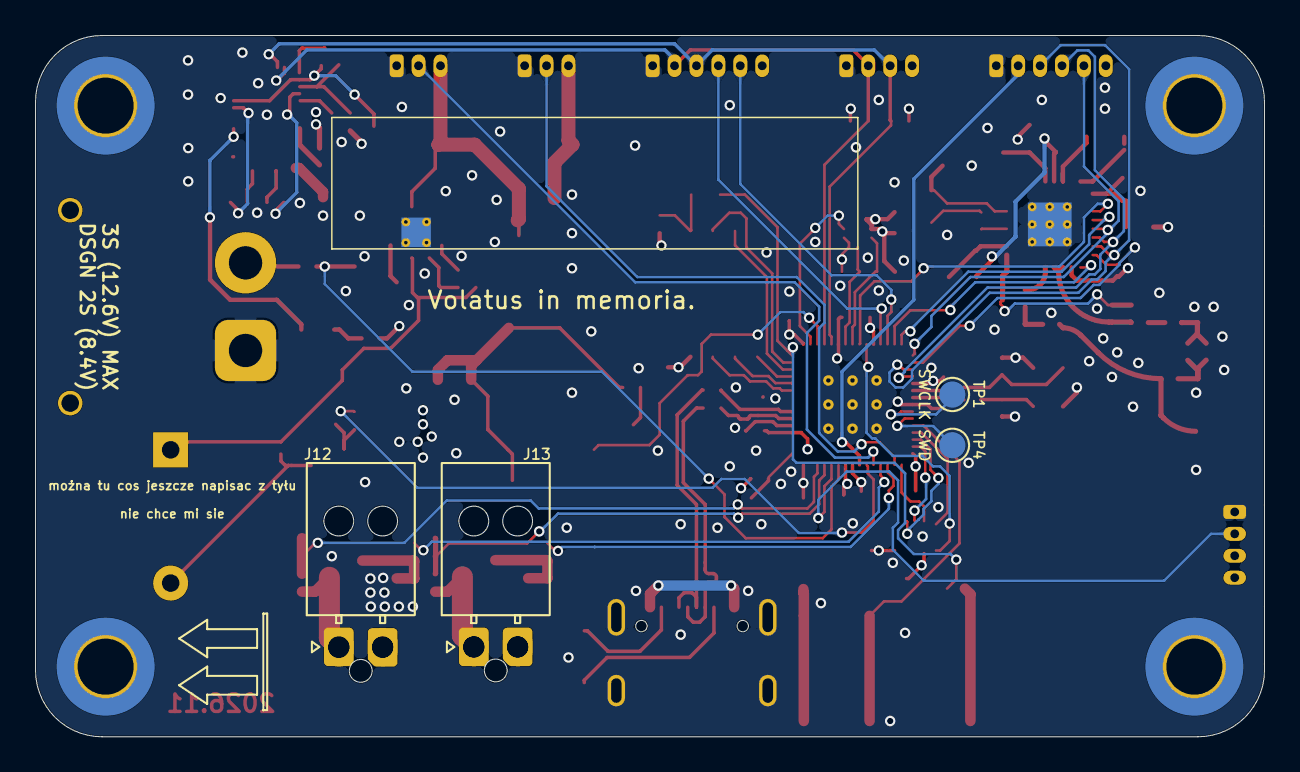
[picture p14: board Hardware/CARP-LITE/rev2.0/CARP.kicad_pcb from below]

Board: 4 copper layers, 70.1 x 40.0 mm, 157 parts (4 on the bottom side), 101 nets.
