aweeri/Control-Avionics-RP2350/Hardware/CARP-DEV/CARP.kicad_pcb

## KiCad design Hardware/CARP-DEV/CARP.kicad_pcb (2026-06-29)

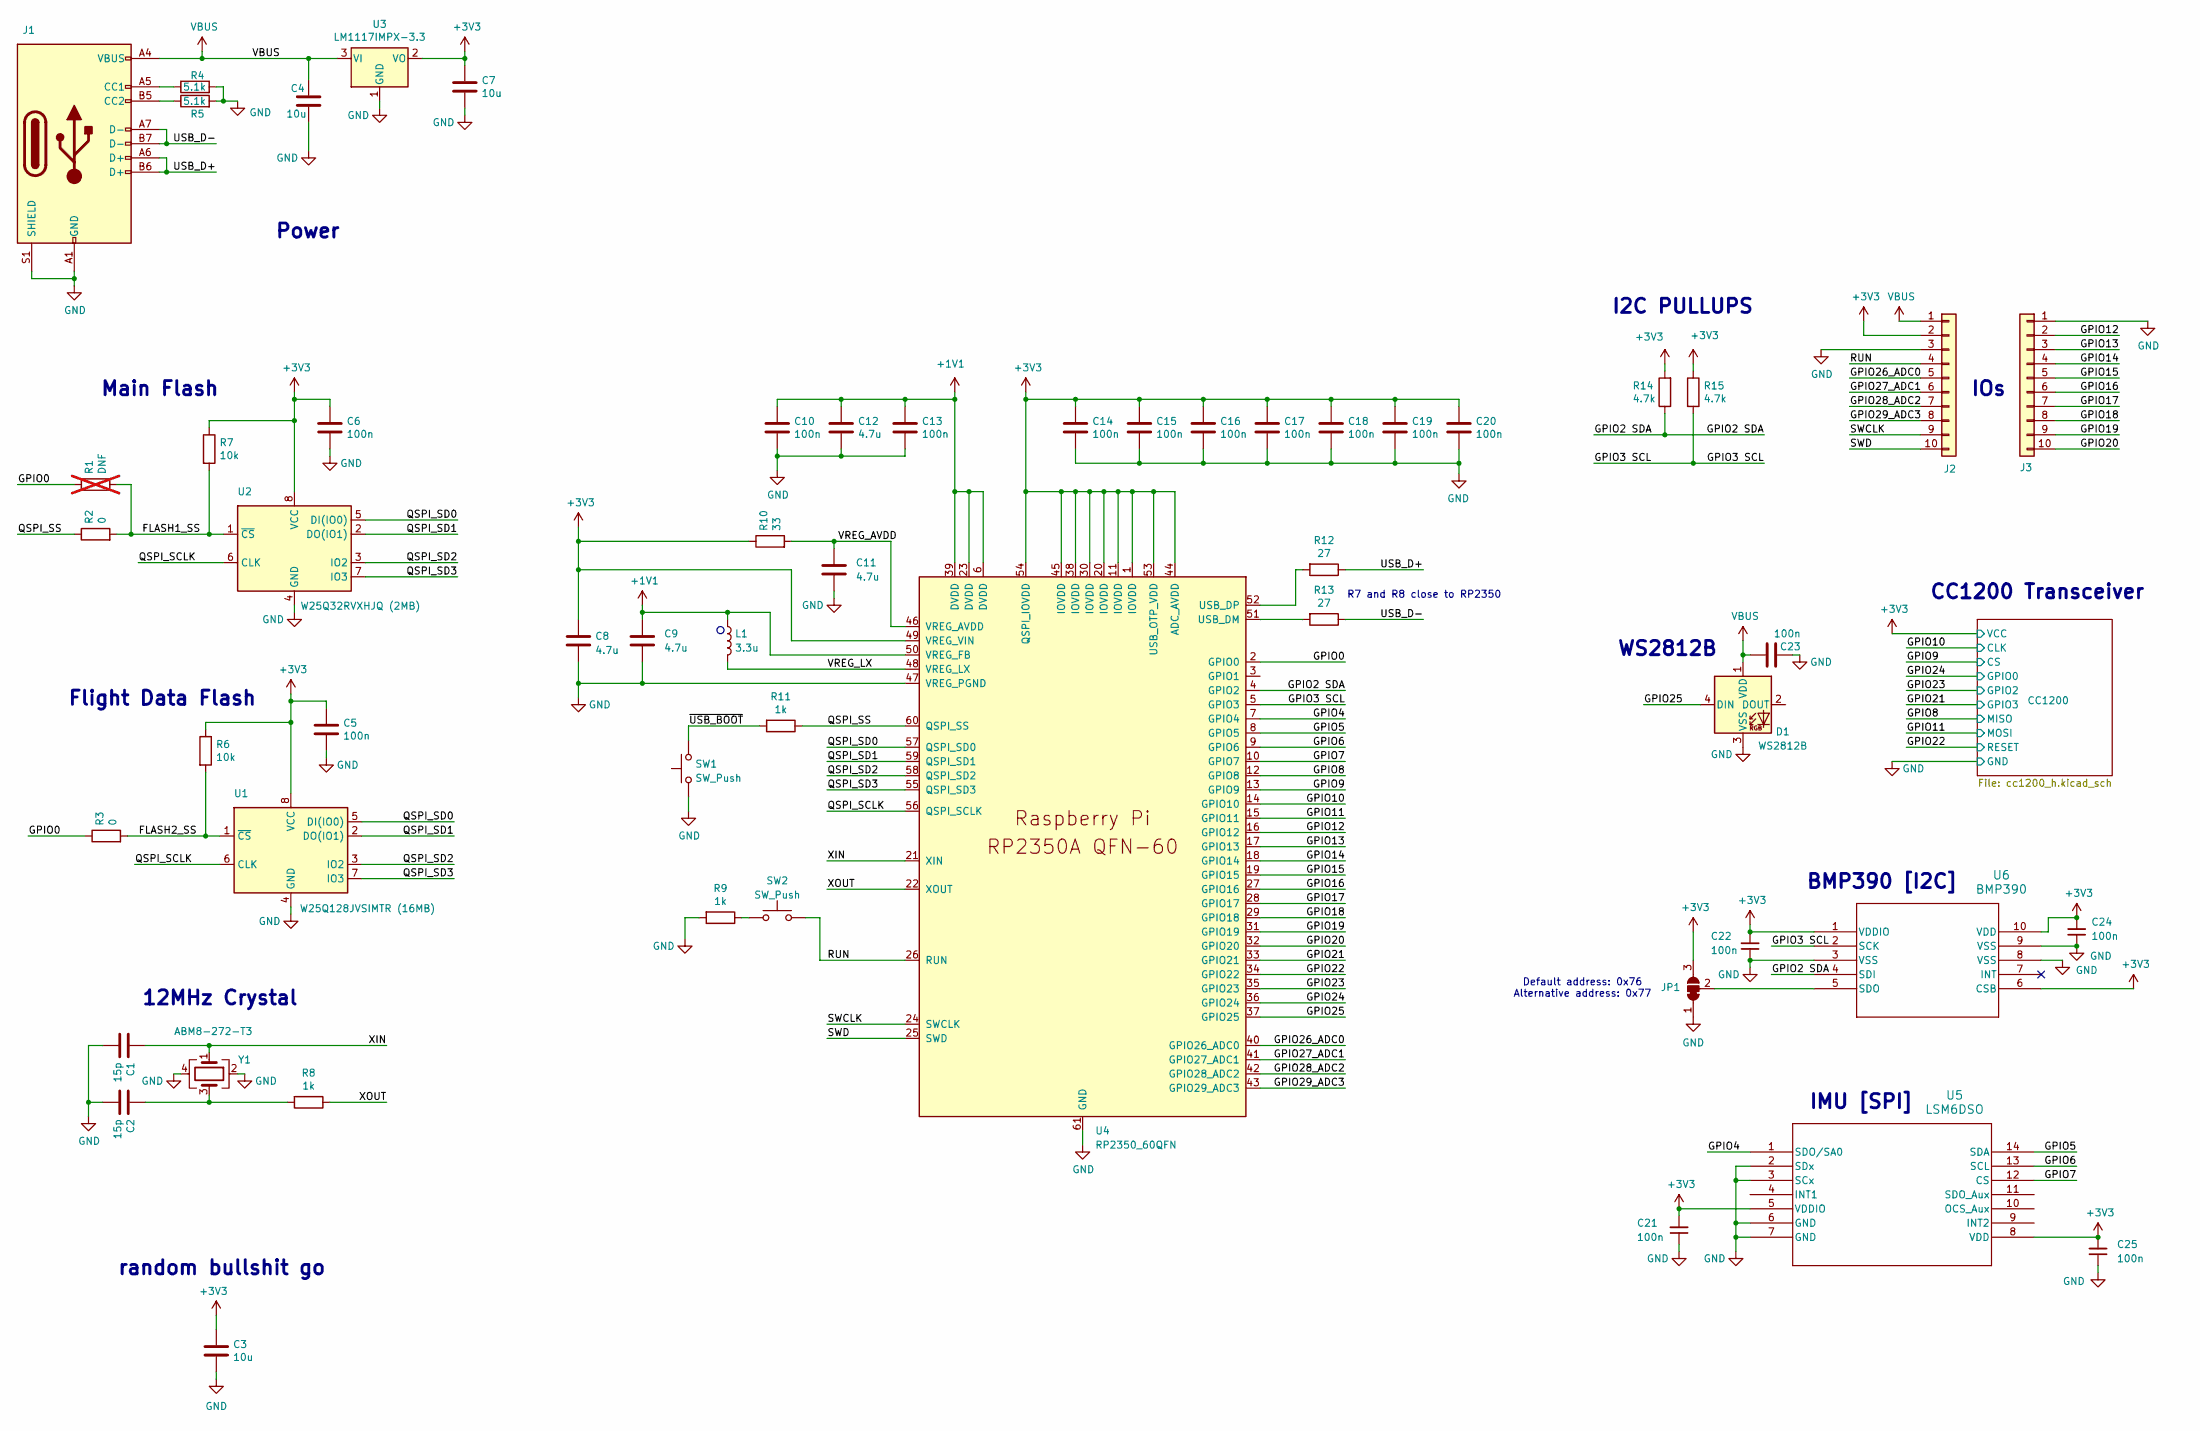
[picture p15: schematic CARP.kicad_sch, RP2350A QFN-60 Dual-Flash testbed]

Parts:
C1, C2: 15p; C_0402_1005Metric
C3, C4, C7: 10u; C_0805_2012Metric
C5, C6, C10, C13, C14, C15, C16, C17, C18, C19, C20, C21, C22, C24, C25: 100n; C_0402_1005Metric
C8, C9: 4.7u; C_0402_1005Metric_small_pads
C11, C12: 4.7u; C_0402_1005Metric
C23: 100n; C_0603_1608Metric
D1: WS2812B; LED_WS2812B_PLCC4_5.0x5.0mm_P3.2mm
J1: USB_C_Receptacle_USB2.0_14P; USB_C_Receptacle_GCT_USB4105-xx-A_16P_TopMnt_Horizontal
J2, J3: Conn_01x10; PinHeader_1x10_P2.54mm_Vertical
JP1: SolderJumper_3_Bridged12; SolderJumper-3_P1.3mm_Bridged12_RoundedPad1.0x1.5mm_NumberL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
L1: 3.3u; L_pol_2016
R1: DNF; R_0603_1608Metric; not fitted
R2, R3: 0; R_0603_1608Metric
R4, R5: 5.1k; R_0402_1005Metric
R6, R7: 10k; R_0603_1608Metric
R8: 1k; R_0402_1005Metric
R9, R11: 1k; R_0603_1608Metric
R10: 33; R_0402_1005Metric
R12, R13: 27; R_0402_1005Metric
R14, R15: 4.7k; R_0402_1005Metric
SW1, SW2: SW_Push; SW_Push_1P1T_NO_Vertical_Wuerth_434133025816
U1: W25Q128JVSIMTR (16MB); SOIC-8_5.3x5.3mm_P1.27mm
U2: W25Q32RVXHJQ (2MB); SOIC-8_5.3x5.3mm_P1.27mm
U3: LM1117IMPX-3.3; SOT-223-3_TabPin2
U4: RP2350_60QFN; RP2350-QFN-60-1EP_7x7_P0.4mm_EP3.4x3.4mm_ThermalVias
U5: LSM6DSO; LGA-14L_2P5X3X0P86_STM
U6: BMP390; 10LGA_2X2X0p75_BOS
Y1: ABM8-272-T3; Crystal_SMD_3225-4Pin_3.2x2.5mm

Connections:
+1V1: C9.1, C10.1, C12.1, C13.1, L1.1, U4.6 (DVDD), U4.23 (DVDD), U4.39 (DVDD), U4.50 (VREG_FB)
+3V3: C3.1, C5.1, C6.1, C7.1, C8.1, C14.1, C15.1, C16.1, C17.1, C18.1, C19.1, C20.1, C21.2, C22.2, C24.2, C25.2, J2.2, JP1.3 (B), R6.1, R7.1, R10.1, R14.2, R15.1, U1.8 (VCC), U2.8 (VCC), U3.2 (VO), U4.1 (IOVDD), U4.11 (IOVDD), U4.20 (IOVDD), U4.30 (IOVDD), U4.38 (IOVDD), U4.44 (ADC_AVDD), U4.45 (IOVDD), U4.49 (VREG_VIN), U4.53 (USB_OTP_VDD), U4.54 (QSPI_IOVDD), U5.5 (VDDIO), U5.8 (VDD), U6.1 (VDDIO), U6.6 (CSB), U6.10 (VDD); also elsewhere on the board
/FLASH1_SS: R1.2, R2.2, R7.2, U2.1 (~CS)
/FLASH2_SS: R3.2, R6.2, U1.1 (~CS)
/GPIO0: R1.1, R3.1, U4.2 (GPIO0)
/GPIO2 SDA: R14.1, U4.4 (GPIO2), U6.4 (SDI)
/GPIO3 SCL: R15.2, U4.5 (GPIO3), U6.2 (SCK)
/GPIO4: U4.7 (GPIO4), U5.1 (SDO/SA0)
/GPIO5: U4.8 (GPIO5), U5.14 (SDA)
/GPIO6: U4.9 (GPIO6), U5.13 (SCL)
/GPIO7: U4.10 (GPIO7), U5.12 (CS)
/GPIO8: U4.12 (GPIO8); also elsewhere on the board
/GPIO9: U4.13 (GPIO9); also elsewhere on the board
/GPIO10: U4.14 (GPIO10); also elsewhere on the board
/GPIO11: U4.15 (GPIO11); also elsewhere on the board
/GPIO12: J3.2, U4.16 (GPIO12)
/GPIO13: J3.3, U4.17 (GPIO13)
/GPIO14: J3.4, U4.18 (GPIO14)
/GPIO15: J3.5, U4.19 (GPIO15)
/GPIO16: J3.6, U4.27 (GPIO16)
/GPIO17: J3.7, U4.28 (GPIO17)
/GPIO18: J3.8, U4.29 (GPIO18)
/GPIO19: J3.9, U4.31 (GPIO19)
/GPIO20: J3.10, U4.32 (GPIO20)
/GPIO21: U4.33 (GPIO21); also elsewhere on the board
/GPIO22: U4.34 (GPIO22); also elsewhere on the board
/GPIO23: U4.35 (GPIO23); also elsewhere on the board
/GPIO24: U4.36 (GPIO24); also elsewhere on the board
/GPIO25: D1.4 (DIN), U4.37 (GPIO25)
/GPIO26_ADC0: J2.5, U4.40 (GPIO26_ADC0)
/GPIO27_ADC1: J2.6, U4.41 (GPIO27_ADC1)
/GPIO28_ADC2: J2.7, U4.42 (GPIO28_ADC2)
/GPIO29_ADC3: J2.8, U4.43 (GPIO29_ADC3)
/QSPI_SCLK: U1.6 (CLK), U2.6 (CLK), U4.56 (QSPI_SCLK)
/QSPI_SD0: U1.5 (DI(IO0)), U2.5 (DI(IO0)), U4.57 (QSPI_SD0)
/QSPI_SD1: U1.2 (DO(IO1)), U2.2 (DO(IO1)), U4.59 (QSPI_SD1)
/QSPI_SD2: U1.3 (IO2), U2.3 (IO2), U4.58 (QSPI_SD2)
/QSPI_SD3: U1.7 (IO3), U2.7 (IO3), U4.55 (QSPI_SD3)
/QSPI_SS: R2.1, R11.1, U4.60 (QSPI_SS)
/RUN: J2.4, SW2.2, U4.26 (RUN)
/SWCLK: J2.9, U4.24 (SWCLK)
/SWD: J2.10, U4.25 (SWD)
/USB_D+: J1.A6 (D+), J1.B6 (D+), R12.1
/USB_D-: J1.A7 (D-), J1.B7 (D-), R13.1
/VREG_AVDD: C11.1, R10.2, U4.46 (VREG_AVDD)
/VREG_LX: L1.2, U4.48 (VREG_LX)
/XIN: C1.1, U4.21 (XIN), Y1.1
/XOUT: R8.1, U4.22 (XOUT)
/~USB_BOOT: R11.2, SW1.2
GND: C1.2, C2.2, C3.2, C4.2, C5.2, C6.2, C7.2, C8.2, C9.2, C10.2, C11.2, C12.2, C13.2, C14.2, C15.2, C16.2, C17.2, C18.2, C19.2, C20.2, C21.1, C22.1, C23.2, C24.1, C25.1, D1.3 (VSS), J1.A1 (GND), J1.A12 (GND), J1.B1 (GND), J1.B12 (GND), J1.S1 (SHIELD), J2.3, J3.1, JP1.1 (A), R4.2, R5.2, R9.2, SW1.1, U1.4 (GND), U2.4 (GND), U3.1 (GND), U4.47 (VREG_PGND), U4.61 (GND), U5.2 (SDx), U5.3 (SCx), U5.6 (GND), U5.7 (GND), U6.3 (VSS), U6.8 (VSS), U6.9 (VSS), Y1.2, Y1.4; also elsewhere on the board
unnamed: C2.1, R8.2, Y1.3
unnamed: J1.A5 (CC1), R4.1
unnamed: J1.B5 (CC2), R5.1
unnamed: JP1.2 (C), U6.5 (SDO)
unnamed: R9.1, SW2.1
unnamed: R13.2, U4.51 (USB_DM)
unnamed: R12.2, U4.52 (USB_DP)
VBUS: C4.1, C23.1, D1.1 (VDD), J1.A4 (VBUS), J1.A9 (VBUS), J1.B4 (VBUS), J1.B9 (VBUS), J2.1, U3.3 (VI)

Notes on the sheet:
random bullshit go
IOs
I2C PULLUPS
CC1200 Transceiver
Main Flash
WS2812B
R7 and R8 close to RP2350
IMU [SPI]
Default address: 0x76 Alternative address: 0x77
BMP390 [I2C]
Flight Data Flash
12MHz Crystal
Power
