aweeri/Control-Avionics-RP2350/Hardware/CARP-DEV/CARP.kicad_pcb

## KiCad design Hardware/CARP-DEV/CARP.kicad_pcb (continued)

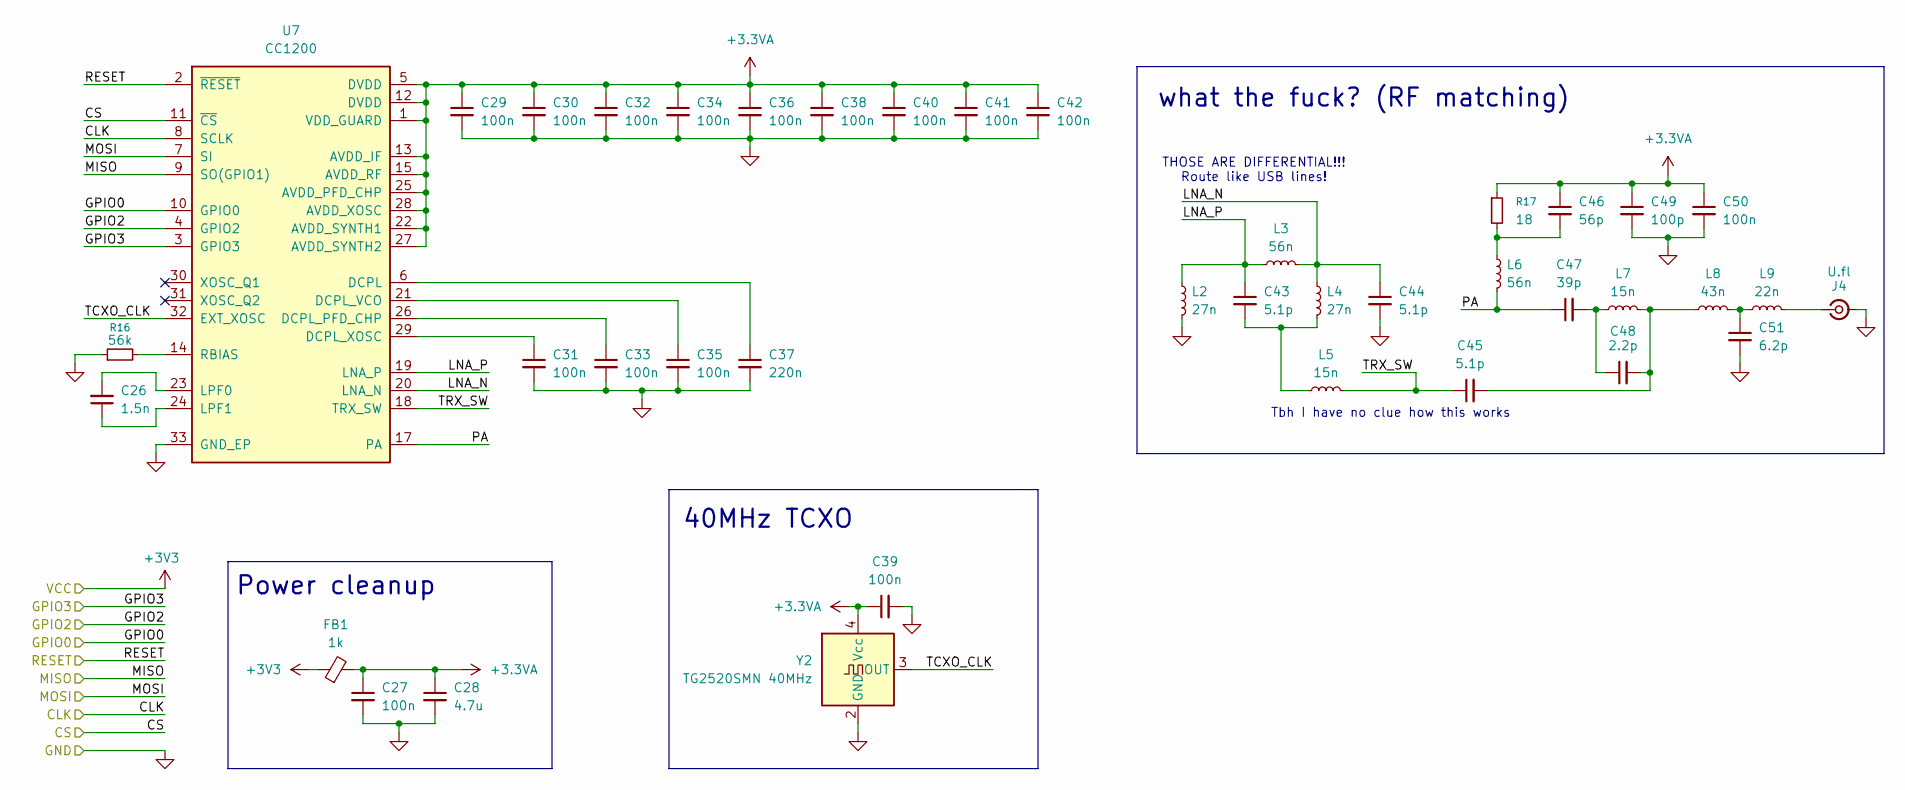
[picture p16: schematic cc1200_h.kicad_sch]

Parts:
C26: 1.5n; C_0402_1005Metric
C27, C29, C30, C31, C32, C33, C34, C35, C36, C38, C39, C40, C41, C42, C50: 100n; C_0402_1005Metric
C28: 4.7u; C_0805_2012Metric
C37: 220n; C_0402_1005Metric
C43, C44, C45: 5.1p; C_0402_1005Metric
C46: 56p; C_0402_1005Metric
C47: 39p; C_0402_1005Metric
C48: 2.2p; C_0402_1005Metric
C49: 100p; C_0402_1005Metric
C51: 6.2p; C_0402_1005Metric
FB1: 1k; L_0402_1005Metric
J4: U.fl; U.FL_Hirose_U.FL-R-SMT-1_Vertical
L2, L4: 27n; L_0402_1005Metric
L3, L6: 56n; L_0402_1005Metric
L5, L7: 15n; L_0402_1005Metric
L8: 43n; L_0402_1005Metric
L9: 22n; L_0402_1005Metric
R16: 56k; R_0402_1005Metric
R17: 18; R_0402_1005Metric
U7: CC1200; QFN-32-1EP_5x5mm_P0.5mm_EP3.45x3.45mm
Y2: TG2520SMN 40MHz; Oscillator_SMD_SeikoEpson_TG2520SMN-xxx-xxxxxx-4Pin_2.5x2.0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

Connections:
+3.3VA: C27.1, C28.1, C29.1, C30.1, C32.1, C34.1, C36.1, C38.1, C39.1, C40.1, C41.1, C42.1, C46.1, C49.1, C50.1, FB1.2, R17.1, U7.1 (VDD_GUARD), U7.5 (DVDD), U7.12 (DVDD), U7.13 (AVDD_IF), U7.15 (AVDD_RF), U7.22 (AVDD_SYNTH1), U7.25 (AVDD_PFD_CHP), U7.27 (AVDD_SYNTH2), U7.28 (AVDD_XOSC), Y2.4 (Vcc)
+3V3: FB1.1; also elsewhere on the board
/CC1200/LNA_N: C44.1, L3.2, L4.1, U7.20 (LNA_N)
/CC1200/LNA_P: C43.1, L2.1, L3.1, U7.19 (LNA_P)
/CC1200/PA: C47.1, L6.2, U7.17 (PA)
/CC1200/TCXO_CLK: U7.32 (EXT_XOSC), Y2.3 (OUT)
/CC1200/TRX_SW: C45.1, L5.2, U7.18 (TRX_SW)
/GPIO8: U7.9 (SO(GPIO1)); also elsewhere on the board
/GPIO9: U7.11 (~CS); also elsewhere on the board
/GPIO10: U7.8 (SCLK); also elsewhere on the board
/GPIO11: U7.7 (SI); also elsewhere on the board
/GPIO21: U7.3 (GPIO3); also elsewhere on the board
/GPIO22: U7.2 (~RESET); also elsewhere on the board
/GPIO23: U7.4 (GPIO2); also elsewhere on the board
/GPIO24: U7.10 (GPIO0); also elsewhere on the board
GND: C27.2, C28.2, C29.2, C30.2, C31.2, C32.2, C33.2, C34.2, C35.2, C36.2, C37.2, C38.2, C39.2, C40.2, C41.2, C42.2, C44.2, C49.2, C50.2, C51.2, J4.2 (Ext), L2.2, R16.1, U7.33 (GND_EP), Y2.2 (GND); also elsewhere on the board
unnamed: C43.2, L4.2, L5.1
unnamed: C45.2, C48.2, L7.2, L8.1
unnamed: C46.2, L6.1, R17.2
unnamed: C47.2, C48.1, L7.1
unnamed: C51.1, L8.2, L9.1
unnamed: J4.1 (In), L9.2
unnamed: C37.1, U7.6 (DCPL)
unnamed: C33.1, U7.26 (DCPL_PFD_CHP)
unnamed: C35.1, U7.21 (DCPL_VCO)
unnamed: C31.1, U7.29 (DCPL_XOSC)
unnamed: C26.2, U7.23 (LPF0)
unnamed: C26.1, U7.24 (LPF1)
unnamed: R16.2, U7.14 (RBIAS)

Notes on the sheet:
40MHz TCXO
what the fuck? (RF matching)
Power cleanup
THOSE ARE DIFFERENTIAL!!! Route like USB lines!
Tbh I have no clue how this works

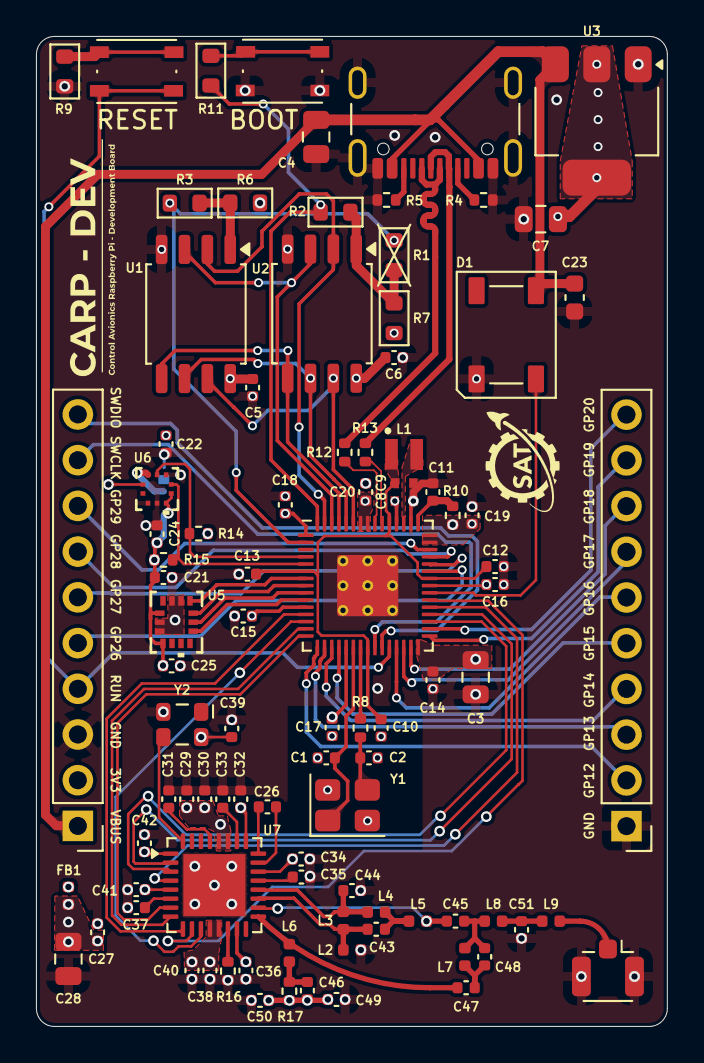
[picture p17: board Hardware/CARP-DEV/CARP.kicad_pcb from above]

Board: 4 copper layers, 35.0 x 55.0 mm, 95 parts (1 on the bottom side), 77 nets.
