aweeri/Control-Avionics-RP2350/(commit log)

2026-06-29 power delivery adjust
    [CARP.kicad_sch]
2026-06-29 adjusted ahead of carplite
    [CARP.kicad_sch]
2026-06-29 autogen PDF schematics
2026-06-29 Auto-generate and update schematic PDFs [skip ci]
2026-06-29 refactor and cleanup
    [CARP.kicad_sch, cc1200.kicad_sch, cc1200_h.kicad_sch]
2026-06-29 Add Mounting Hole symbols to schematic and update designators
    [CARP.kicad_sch]
2026-06-29 Add pyro with continuity checks and critical i/o
    [CARP.kicad_sch]
2026-06-29 more stuff
    [CARP.kicad_pcb, CARP.kicad_sch]
2026-06-29 Add TODO notes for footprint optimization and pyro circuit checks
    [CARP.kicad_sch]
2026-06-30 fp changes
    [CARP.kicad_sch]
2026-06-30 pcb changes
    [CARP.kicad_pcb, CARP.kicad_sch]
2026-06-30 pwr changes
    [CARP.kicad_pcb, CARP.kicad_sch]
2026-07-01 more fp changes
    [CARP.kicad_sch]
2026-07-01 change jst to picoblade
    [CARP.kicad_pcb, CARP.kicad_sch]
2026-07-18 Add LR2021 symbol
    [CARP.kicad_sch, radio.kicad_sch]
2026-07-19 radio idk
    [CARP.kicad_pcb, CARP.kicad_sch, radio.kicad_sch]
2026-07-19 Forgor to save oops
    [radio.kicad_sch]
2026-07-19 Update button footprint to proper one
    [CARP.kicad_pcb, CARP.kicad_sch, radio.kicad_sch]
2026-07-23 do pyro shebang and pcb work
    [CARP.kicad_pcb, CARP.kicad_sch]
2026-07-23 Add preliminary buck design
    [CARP.kicad_sch]
2026-07-23 add link to sim
    [CARP.kicad_sch]
2026-08-03 move stuff around
    [CARP.kicad_pcb, CARP.kicad_sch]
2026-08-09 power delivery revamp
    [CARP.kicad_pcb, CARP.kicad_sch]
2026-08-09 add tantals
    [CARP.kicad_sch]
2026-08-10 rem ldo
    [CARP.kicad_sch]
2026-08-10 fp cahnges
    [CARP.kicad_sch, radio.kicad_sch]
2026-08-10 Change passives footprints to 0603
    [CARP.kicad_sch]
2026-08-10 nothing specific
    [CARP.kicad_pcb]
2026-08-11 pcb work
    [CARP.kicad_pcb, CARP.kicad_sch]
2026-08-11 tune usb lines
    [CARP.kicad_pcb]
2026-08-11 buck and ldo
    [CARP.kicad_pcb, CARP.kicad_sch]
2026-08-12 god is dead and we have killed him
    [CARP.kicad_pcb]
2026-08-12 łełołeło
    [CARP.kicad_pcb, CARP.kicad_sch]
2026-08-12 missed another one
    [CARP.kicad_pcb]
2026-08-12 update inductor
    [CARP.kicad_pcb, radio.kicad_sch]
2026-08-12 update values
    [radio.kicad_sch]
2026-08-12 radio silkscreen
    [CARP.kicad_pcb]
2026-08-12 change sizes
    [CARP.kicad_pcb, CARP.kicad_sch, radio.kicad_sch]
2026-08-12 change more sizes
    [CARP.kicad_pcb, CARP.kicad_sch]
2026-08-12 more sizer changers
    [CARP.kicad_pcb, CARP.kicad_sch]
2026-08-13 soldermask updt
    [CARP.kicad_pcb, CARP.kicad_sch]
2026-08-13 fix autocommit bullshit
    [CARP.kicad_pcb]
2026-08-13 ready for production
    [CARP.kicad_pcb]
2026-08-26 move carp lite to revision subdir
    [10LGA_2X2X0p75_BOS.stl, CARP.kicad_pcb, CARP.kicad_sch, RP2350_QFN60.step, radio.kicad_sch]
2026-08-26 add rev2.0
    [10LGA_2X2X0p75_BOS.stl, CARP.kicad_pcb, CARP.kicad_sch, RP2350_QFN60.step, radio.kicad_sch]
2026-08-26 correct drc issues: flight data flash power and flipped resistor (doesnt matter but drc complained)
    [CARP.kicad_pcb]
2026-08-26 flip pcb for better fullscreen ops
    [CARP.kicad_pcb]
2026-08-26 make silkscreen smaller and adjust parts of it
    [CARP.kicad_pcb]
2026-08-26 Move some of the vias out of the pads
    [CARP.kicad_pcb]
2026-08-27 adjust silkscreen
    [CARP.kicad_pcb, CARP.kicad_sch]
2026-08-27 unfuck lga
    [CARP.kicad_pcb]
2026-08-31 move vias from pads
    [CARP.kicad_pcb]
2026-09-02 update dataframes and push radio in imuless
2026-09-02 imuless update
2026-09-02 add arm/disarm
2026-09-03 allow power override in testbench
2026-09-03 just switch to SF7
2026-09-05 correct x orient and baro issue
    [RapidFish_v2.ino, analyze_flight.py, dump_flash.py, parse_flight.py]
2026-09-05 fix compile + yum buns
    [RapidFish_v2.ino]
2026-09-06 rev 2 schematic changes
    [CARP.kicad_sch, radio.kicad_sch]
2026-09-06 radio dosen't need two interrupts
    [CARP.kicad_sch, radio.kicad_sch]
2026-09-06 more rev2 schematic stuff
    [CARP.kicad_sch]
2026-09-07 2/3S Lithium Cell Charger
    [CARP.kicad_sch, lithium_charger.kicad_sch]
2026-09-07 update revision on schematics
    [CARP.kicad_sch, lithium_charger.kicad_sch, radio.kicad_sch]
2026-09-07 IMU interrupt GPIO fix
    [CARP.kicad_pcb, CARP.kicad_sch]
2026-09-07 Replace baro with BMP581 and some small changes
    [CARP.kicad_sch]
2026-09-07 C28 wasnt aligned...
    [CARP.kicad_sch]
2026-09-07 Also R16....
    [CARP.kicad_sch]
2026-09-08 mess up pcb a bit
    [CARP.kicad_pcb, CARP.kicad_sch]
2026-09-08 rearrange insides
    [10LGA_2X2X0p75_BOS.stl, CARP.kicad_pcb, CARP.kicad_sch, RP2350_QFN60.step, cc1200.kicad_sch, cc1200_h.kicad_sch, radio.kicad_sch]
2026-09-08 pcb and schematic changes
    [CARP.kicad_pcb, CARP.kicad_sch]
2026-09-11 lithium charger is for carp lite rev 2, not carp dev
    [CARP.kicad_pcb, lithium_charger.kicad_sch]
2026-09-15 more rev2 changes
    [CARP.kicad_pcb, CARP.kicad_sch]
2026-09-15 rev pcb finished?
    [CARP.kicad_pcb]
2026-09-15 move around silkscreen
    [CARP.kicad_pcb]
2026-10-02 extra connector
    [CARP.kicad_pcb, CARP.kicad_sch]
